tirthlodaya/Pen-Plotter/CAD file Pen plotter/GENERAL_PARTS/20mm-microswitch-1.snapshot.2/Microswitch20.jpg

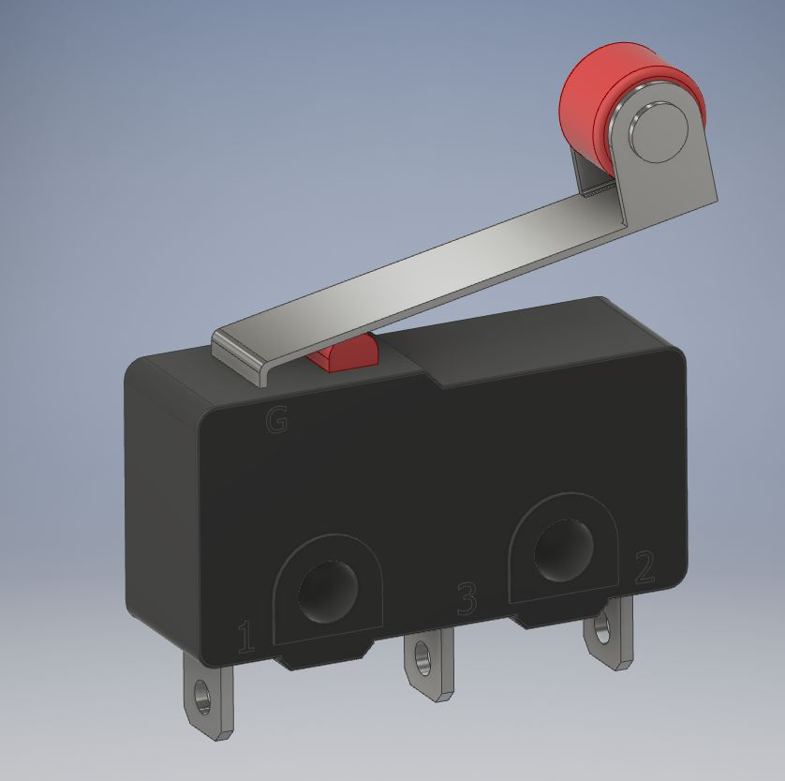
CAD file Pen plotter/GENERAL_PARTS/20mm-microswitch-1.snapshot.2/Microswitch20.jpg
