tirthlodaya/Pen-Plotter/Images_&_Videos_penplotter/full_assembly.jpg

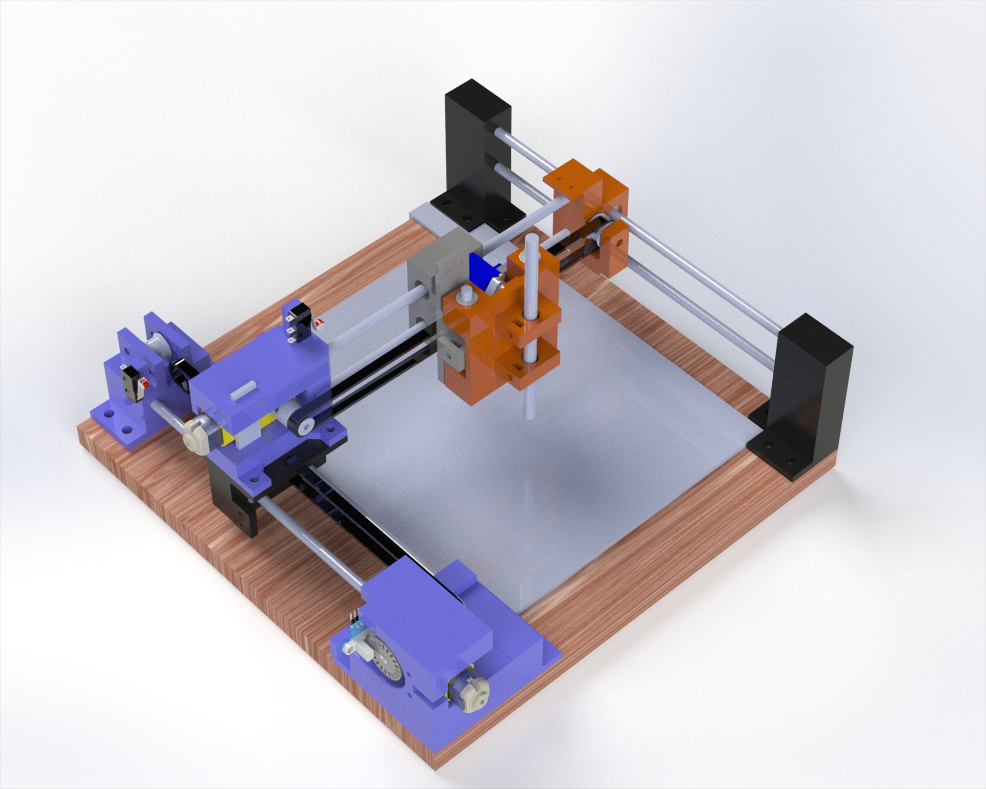
Images_&_Videos_penplotter/full_assembly.jpg
