tirthlodaya/Pen-Plotter/CAD file Pen plotter/dc-motor-gearbox-tt-motor-1.snap 2/DC Motor Gearbox.JPG

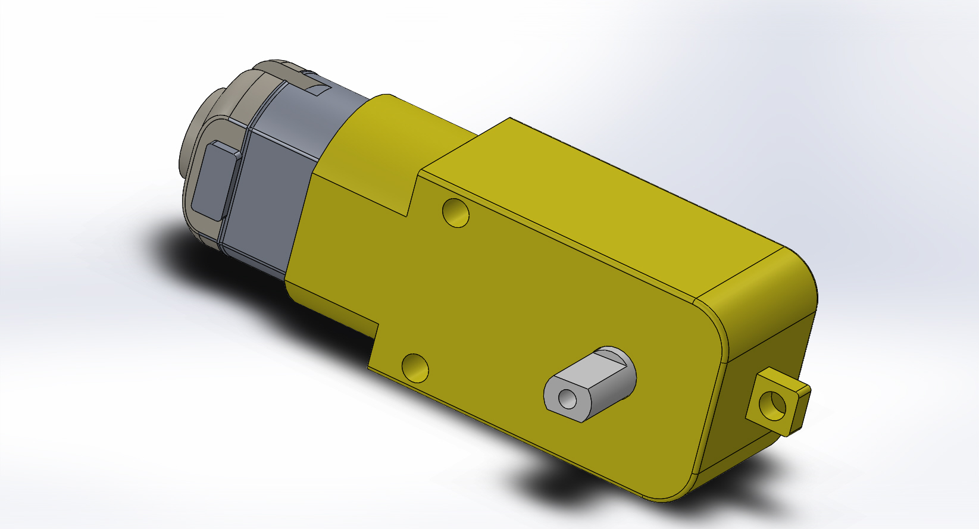
CAD file Pen plotter/dc-motor-gearbox-tt-motor-1.snap 2/DC Motor Gearbox.JPG
