tirthlodaya/Pen-Plotter/electronics_penplotter/circuit diagram.jpg

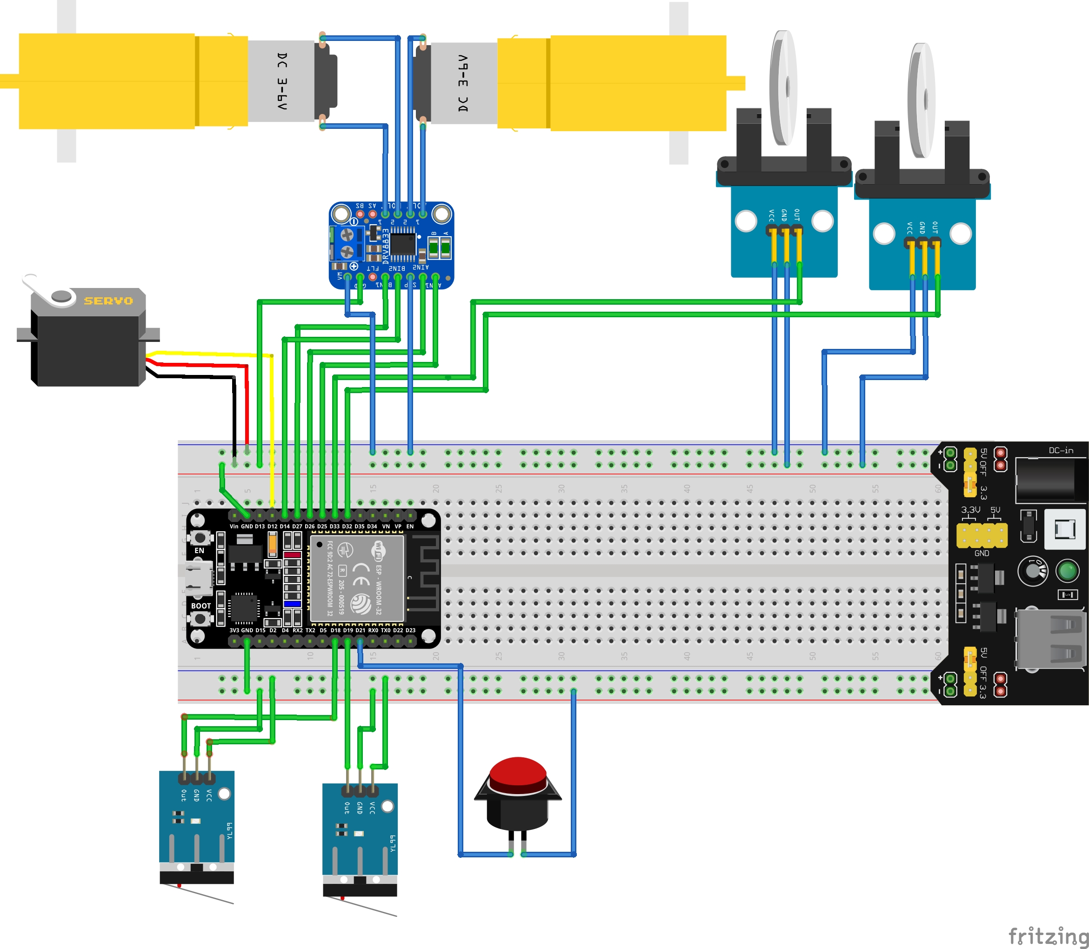
electronics_penplotter/circuit diagram.jpg
