tirthlodaya/Pen-Plotter/electronics_penplotter/Schematic_diagram.jpg

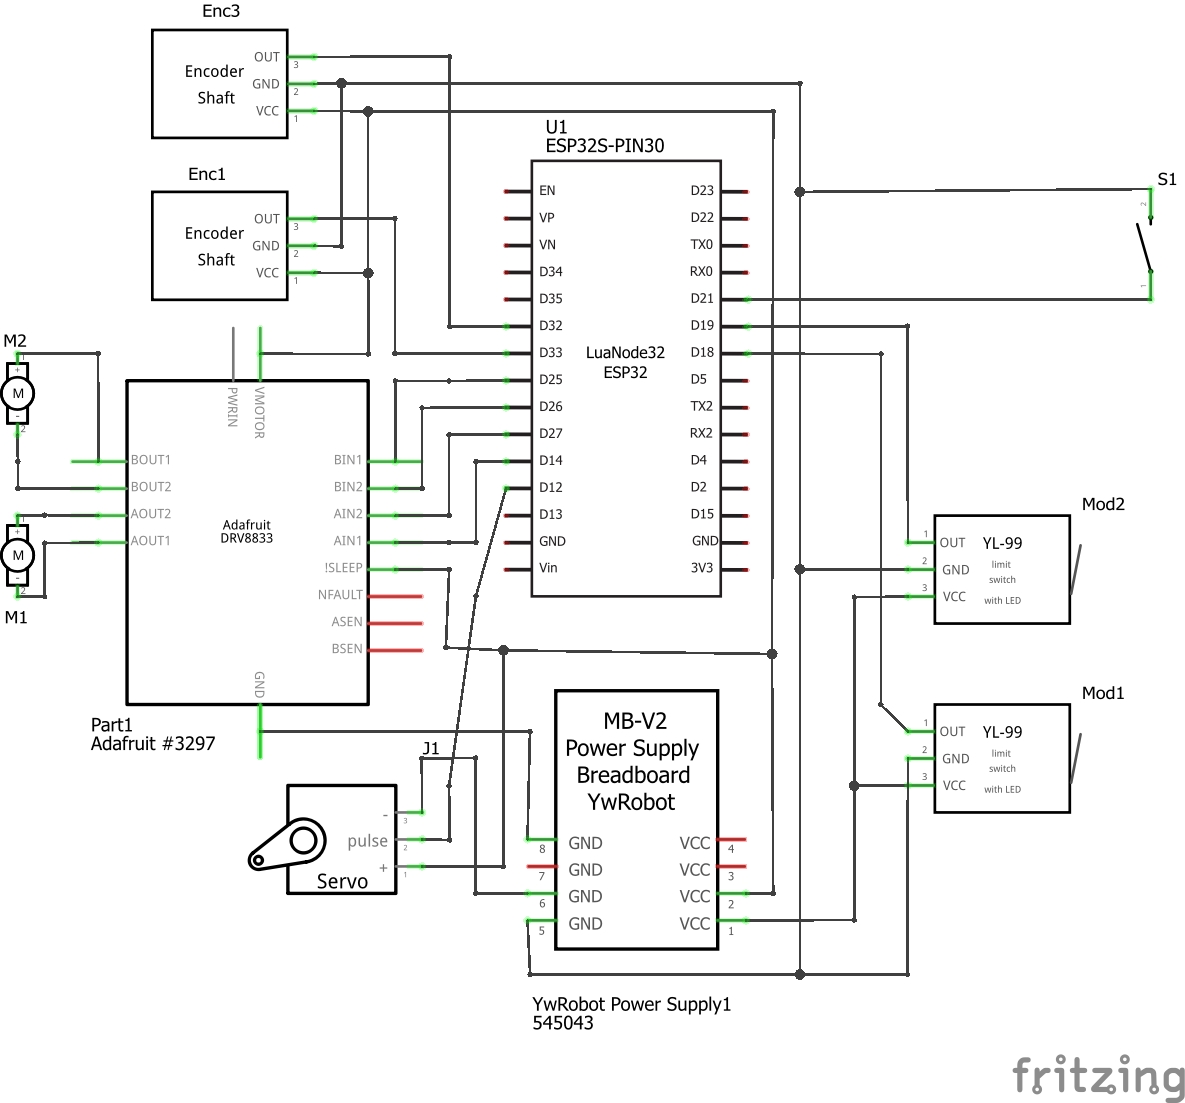
electronics_penplotter/Schematic_diagram.jpg
