tirthlodaya/Pen-Plotter/Images_&_Videos_penplotter/Repeatability_image.jpg

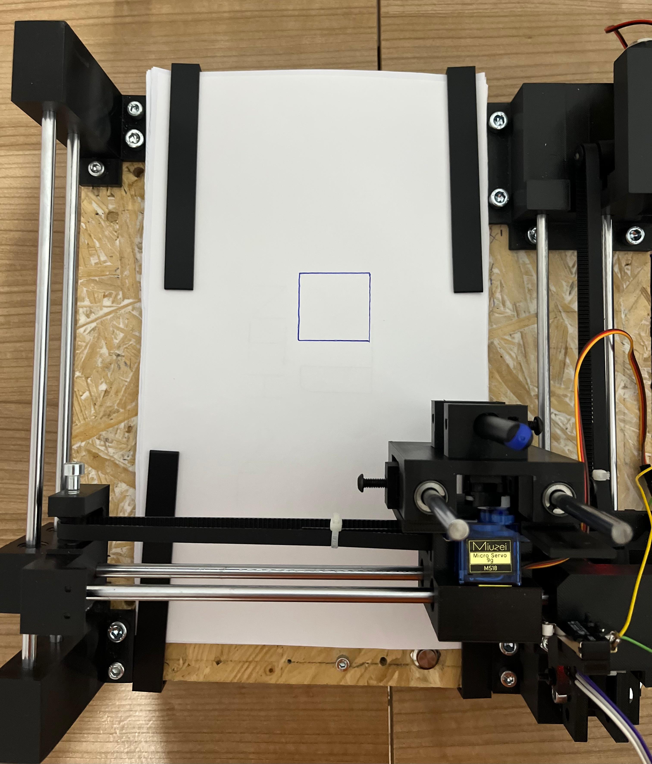
Images_&_Videos_penplotter/Repeatability_image.jpg
