tirthlodaya/Pen-Plotter/documents_penplotter/Requirements_Engineering_XY_PenPlotter.xlsx

User Requirement |  |  |  |  |  |  | Technical Specification |  |  |  |  |  |  |  | Design Specification |  |  |  |  |  |  | Verification Protocol |  |  |  |  |  |  | Verification Report |  |  |  |  |  |  |  |  | Validation Protocol |  |  |  |  | Validation Report
UR # | module | Title | User Requirement | Remark | Domain (HW/SW/ME/all) | Must / Wish | TS # | ref. to UR # | module | Title | Technical Requirement | Remark | Domain (HW/SW/ME/all) | Must / Wish | DS # | ref. to TS # | module | Reference (# bill of materials, article # supplier part, ref. doc # etc..) to implementation | Description | Remark | Domain (HW, SW, ME, all) | VerP # | ref to TS # | module | test procedure (description of routine) | verification criterion | ref. # (i.e. test protocol,etc.) | Domain (HW/SW/ME/all) | VerR # | VerP # | module | Test function | nominal criterion, target value | actual value | criterion passed / failed | remark | Domain (HW/SW/ME/all) | ValP # | ref. to UR # | module | validation procedure (description of routine) | vaidation criteria | ValR # | ref. to ValP # | module | criteria passed / failed
Application |  |  |  |  |  |  | Application |  |  |  |  |  |  |  | Application |  |  |  |  |  |  | Application |  |  |  |  |  |  | Application |  |  |  |  |  |  |  |  | Application
UR1 | application | intended use | The XY-pen plotter is designed to draw a Nikolaus house after programming and can be used within the laboratory of University by students taking part in Master course MERO for educational reasons. |  | all | M | TS1 | UR1 | application | intended use | The plotter is designed and programed to carry out certain tasks and objectives like drawing the Nikolaus hause. |  | all | M | DS1 | TS1 | application | bill of materials | Embedded drawing logic (on the ESP32) that interprets those vectors into coordinated X–Y motion and pen-lift commands. |  | all | VerP1 | TS1 | Application | Upload Nikolaus house drawing to plotter; observe execution. | Plot matches shape/scale of reference drawing. |  | All | VerR1 | VerP1 | Application | Upload Nikolaus house drawing to plotter; observe execution. | Plotter completes full Nikolaus house drawing and in correct sequence | Plot completed successfully | passed |  | All | ValP1 | UR1, UR2,UR9 | application | Run the XY-pen plotter to draw the Nikolaus house for 50 cycles, ensuring correct performance in speed, precision, and accuracy. | The plotter must draw the Nikolaus house correctly in all 50 cycles without errors, maintaining accuracy within defined tolerance limits and operating without failure. | ValR1 | ValP1 | application | passed
UR2 | application | use case | The plotter has to draw a Nikolaus' house |  | all | M | TS2 | UR2 | application | use case | The Nikolaus house has a plotting area of 100 x 100 mm² maximum. |  | all | M | DS2 | TS2 | application | Workshop_II_-_MERO_S25_V2.pdf | Plotting area limited to 100 x 100 mm². |  | all | VerP2 | TS2 | Application | Measure drawing area with ruler. | Plotting area =100×100 mm². |  | All | VerR2 | VerP2 | Application | Measure drawing area with ruler. | Drawing dimensions match design within ±2 mm tolerance | Measured area: 100 mm × 100 mm | passed |  | All | ValP2 | UR3 | application | Test the XY-pen plotter by connecting it to a standard household power supply and running the drawing task for at least 50 cycles. | The plotter must operate reliably and consistently when powered by a household power supply, without power-related issues or interruptions during the 50 cycles. | ValR2 | ValP2 | application | passed
UR3 | application | user environment | The plotter should operate on household power supply |  | all | M | TS3 | UR3 | application | user environment | The plotter should operate on 5V DC . |  | all | M | DS3 | TS3 | application | bill of materials | The plotter should operate on 5V DC . |  | all | VerP3 | TS3 | Application | Supply 5V DC power and test full functionality of the plotter during a complete drawing cycle. | Plotter powers on and operates reliably and safely on 5V DC without performance issues. |  | All | VerR3 | VerP3 | Application | Supply 5V DC power and test full functionality of the plotter during a complete drawing cycle. | Plotter completes full drawing cycle without malfunction | Plot completed successfully | passed |  | All | ValP3 | UR4, UR5 | general | Ensure that the XY-pen plotter can be easily carried by the user and operated by students by testing its portability and user interface, with students successfully completing the drawing task without difficulty. | The plotter should be lightweight and portable for easy handling by the user. The interface must be intuitive, allowing students to operate the plotter with minimal training or assistance. | ValR3 | ValP3 | general | passed
General Functions |  |  |  |  |  |  | General Functions |  |  |  |  |  |  |  | General Functions |  |  |  |  |  |  | General Functions |  |  |  |  |  |  | General Functions |  |  |  |  |  |  |  |  | ValP4 | UR6 | general | Measure the plotter's dimensions and ensure it fits into a designated box for storage. | The plotter must fit comfortably in the box without any parts sticking out or being compressed. | ValR4 | ValP4 | general | passed
UR4 | general | portability | XY pen plotter shall be carried by user. | weight up to 3.5kg. | all | M | TS4 | UR4 | general | portability | The pen plotter should not exceed 3.5 kg |  | all | M | DS4 | TS4 | general |  | Total weight must be under 3.5 kg for portability by a single user. |  | all | VerP4 | TS4 | General | Weigh complete plotter with digital scale. | Total weight ≤3.5 kg. |  | All | VerR4 | VerP4 | General | Weigh complete plotter with digital scale. | Total weight within design limit | less than 3.5kg | passed |  | All | ValP5 | UR10, UR11 | general | Ensure that all components are easy to assemble and the plotter is designed for easy access to replaceable parts. | Components should fit together easily, and parts like the pen, motors, and belts should be accessible for replacement without requiring disassembly. | ValR5 | ValP5 | general | passed
UR5 | general | User Interface | XY Pen Plotter shall be easily operated by the students |  | SW | M | TS5 | UR4 | general | portability | The pen plotter has to be carried by a single user without difficulty |  | SW | M | DS5 | TS5 | general |  | Design the plotter to be lightweight, compact, and ergonomically shaped for easy transport by a single user. |  | SW | VerP5 | TS5 | General | Carry plotter by hand over 200 m distance. | One person carries comfortably without strain. |  | SW | VerR5 | VerP5 | General | Carry plotter by hand over 200 m distance. | No mechanical or electrical damage during/after transport | No damage, powered on and functioned well | passed |  | SW | ValP6 | UR12,UR14 | base plate | Ensure the paper stays in place on the base plate during operation and test the plotter with different paper sizes. | The paper must remain securely in place throughout operation, and the plotter must support multiple paper sizes with easy adjustments. | ValR6 | ValP6 | base plate | passed
UR6 | general | dimensions | XY pen plotter has to fit in a box |  | all | M | TS6 | UR5 | general | User Interface | The plotter should be designed for user friendly operation |  | SW | W | DS6 | TS6 | general |  | Design the plotter with an intuitive interface, clear status indicators, easy pen and paper handling, and automated calibration to ensure user-friendly operation. |  | all | VerP6 | TS6 | General | User operates plotter using interface; record feedback. | User completes basic task without guidance. |  | SW | VerR6 | VerP6 | General | User operates plotter using interface; record feedback. | User able to operate easily; feedback indicates intuitive interface | Interface easy to use; positive feedback | passed |  | SW | ValP7 | UR15 | Frame | Ensure the frame is tested for stability and rigidity during operation. | The frame must remain stable and rigid without any wobbling or flexing during the plotter's operation. | ValR7 | ValP7 | Frame | passed
UR7 | general | Indicator | XY Pen Plotter shall give a signal when it is turned On and shall give a different signal when emergency is pressed |  | SW | W | TS7 | UR6 | general | dimensions | Dimensions less than 56x39x27 cm2 |  | all | M | DS7 | TS7 | general |  | Plotter dimensions must not exceed 56 x 39 x 27 cm³. |  | SW | VerP7 | TS7 | General | Measure dimensions with tape scale of plotter | All dimensions ≤56×39×27 cm³ |  | All | VerR7 | VerP7 | General | Measure dimensions with tape scale of plotter | Dimensions match design within ±2 mm tolerance | 305 x 305 x 15 mm | passed |  | All | ValP8 | UR17,UR18 | Pen-Holder | Ensure the pen-holder is tested to hold pens of various diameters and allow vertical movement. | The pen-holder must securely hold pens of different diameters and enable stable vertical movement during operation. | ValR8 | ValP8 | Pen-Holder | passed
UR8 | general | Dustgaurd | IC-Layout XY Pen Plotter shall be designed such that it should avoid collection of dirt and dust from the environment |  | HW | W | TS8 | UR7 | general | Indicator | An LED light to signal machine operation. |  | SW | W | DS8 | TS8 | general |  | LED light must indicate machine operation clearly. |  | HW | VerP8 | TS8 | General | Power on machine and observe LED status. | LED lights up during operation. |  | SW | VerR8 | VerP8 | General | Power on machine and observe LED status. | Status LEDs turn ON as per expected startup pattern | GREEN LED for Start and RED LED for Emergency | failed |  | SW | ValP9 | UR19,UR20,UR31 | Slider and Acutation | Ensure the plotter uses actuators for customized positioning, maintains high precision and accuracy in slider movement, and effectively translates rotary motor motion into smooth linear movement. | The plotter must use actuators that allow customized positioning, with the slider maintaining high precision and accuracy for detailed plots, and the rotary motion of the motor must be seamlessly converted into smooth, accurate linear movement. | ValR9 | ValP9 | Slider and Acutation
UR9 | general | Lifecycle | Pen-Plotter should operate atleast 50 cycle |  | all | W | TS9 | UR8 | general | Circuit Protection | 3D printed box to prevent dust and dirt. |  | HW | W | DS9 | TS9 | general | bill of materials | Enclosure must be 3D printed to shield against dust and dirt. |  | all | VerP9 | TS9 | General | Inspect enclosure material and fitment. | 3D-printed box fully covers and seals system. |  | HW | VerR9 | VerP9 | General | Inspect enclosure material and fitment. | Enclosure securely fitted, no loose parts, durable material | Stable 3D printed material for casing | passed |  | HW | ValP10 | UR22,UR23 | Motor Controller | Ensure the voltage and current are regulated to the motors during operation. | The motors should receive stable, regulated voltage and current to prevent performance issues or damage. | ValR10 | ValP10 | Motor Controller | passed
UR10 | general | Assembly | All component are easy to assemble. |  | all | M | TS10 | UR9 | general | Lifecycle | Closed loop control for higher lifecycle |  | all | W | DS10 | TS10 | general |  | Implement closed-loop motor control using feedback sensors to monitor and adjust motion in real time, ensuring precise operation, reduced wear, and extended component lifespan |  | all | VerP10 | TS10 | General | Check sensor feedback and correction loop. | System adjusts based on sensor feedback. |  | All | VerR10 | VerP10 | General | Check sensor feedback and correction loop. | Sensors provide accurate data; system corrects position as expected | Encoder feedback working, path corrected | passed |  | All | ValP11 | UR24,UR25,UR26,UR29 | Control and Coding | Ensure the drive system has selectable preset speeds, regulated voltage and current to motors, seamless integration with a microcontroller, limit switches for origin detection, an emergency stop provision, and automatic home position calibration. | The system must provide selectable preset speeds, stable motor regulation, integrate seamlessly with the microcontroller, accurately detect the origin via limit switches, include an operational emergency stop, and automatically calibrate to the home position before each operation. | ValR11 | ValP11 | Control and Coding | passed
UR11 | general | Ease of Maintenance | Ensure the plotter is designed for easy access to replaceable parts. |  | all | M | TS11 | UR10, UR11 | general | Assembly | All components of the pen plotter are modularily designed |  | all | M | DS11 | TS11 | general | Assembly_group16 | All components must be modular for easy maintenance and upgrade. |  | all | VerP11 | TS11 | General | Try removing modules | Modules can be separated easily |  | All | VerR11 | VerP11 | General | Try removing modules | Modules can be safely disconnected without damaging system or other components | Modules removable, no damage observed | passed |  | All | ValP12 | UR30, UR31 | Wiring and Power supply | Ensure standardized wires are used, all wires are inside a cable protector, and the plotter operates reliably on direct electrical power without batteries. | The plotter must have standardized wiring with all wires protected inside a cable protector and must operate reliably on direct electrical power without the use of batteries. | ValR12 | ValP12 | Wiring and Power supply | passed
Module Function base plate |  |  |  |  |  |  | Module Function base plate |  |  |  |  |  |  |  | Module Function base plate |  |  |  |  |  |  | Module Function base plate |  |  |  |  |  |  | Module Function - base plate |  |  |  |  |  |  |  |  | ValP13 | UR33,UR35 | Regulatory & standards | Ensure the device is designed according to relevant safety standards, and verify that the firmware follows established coding standards for reliability and maintainability. | The device must comply with applicable safety standards, and the firmware must adhere to coding standards to ensure long-term reliability and ease of maintenance. | ValR13 | ValP13 | Regulatory & standards | passed
UR12 | base plate | paper fixation | The paper should stay in place on the base plate during operation. | Implement grips | HW | M | TS12 | UR12 | base plate | Paper fixation | The base plate have to be encapsulated with grippers to hold the paper in proper position w/o movement during drawing cylce |  | HW | M | DS12 | TS12 | base plate | Assembly_group16 | Paper holding system (grippers) to prevent movement during plotting. |  | HW | VerP12 | TS12 | base plate | Plot and check paper movement | Paper stays fixed throughout cycle |  | HW | VerR12 | VerP12 | base plate | Plot and check paper movement | Paper does not move during operation | Smooth paper feed,stable and aligned | passed |  | HW
UR13 | Base Plate | Quality | The base plate shall be made of good quality material | - | HW | M | TS13 | UR13 | base plate | Quality | the base surface should be smooth, low-maintenance, durable. |  | HW | M | DS13 | TS13 | base plate |  | Base surface must be smooth, durable, and low-maintenance. |  | HW | VerP13 | TS13 | base plate | Inspect and touch base surface | Base is smooth, easy to clean |  | HW | VerR13 | VerP13 | base plate | Inspect and touch base surface | Base surface is flat, stable, and vibration-free | Not Smooth, no vibration | failed |  | HW
UR14 | Base Plate | Dimension | Supports multiple different paper sizes | - | HW | M | TS14 | UR14 | base plate | Dimensions | The dimension of base plate should be such that it can hold paper from 10x10 cm upto A4 Size |  | HW | W | DS14 | TS14 | base plate | Workshop_II_-_MERO_S25_V2.pdf | Base plate must support paper from 10x10 cm to A4 size. |  | HW | VerP14 | TS14 | base plate | Try fitting both sizes | Both sizes fit securely on base |  | HW | VerR14 | VerP14 | base plate | Try fitting both sizes | Plotter accommodates both intended paper sizes securely | A4 and A5 fit securely | passed |  | HW
Module Function - Frame |  |  |  |  |  |  | Module Function frame |  |  |  |  |  |  |  | Module Function frame |  |  |  |  |  |  | Module Function frame |  |  |  |  |  |  | Module Function frame
UR15 | Frame | Structure Layout | The frame must be stable and rigid. |  | all | M | TS15 | UR15 | Frame | Structure Layout | The frame shall maintain structural stability and rigidity to minimize vibrations during operation, ensuring plotting accuracy with a maximum positional deviation of less than 0.5 mm. |  | all | M | DS15 | TS15 | Frame | Assembly_group16 | Structure must be rigid and stable to avoid vibration. |  | all | VerP15 | TS15 | Frame | Observe motion during plotting | No visible vibrations; smooth plotting |  | All | VerR15 | VerP15 | Frame | Observe motion during plotting | Motion is smooth, with no jitter, backlash, or sudden stops | Motion smooth and consistent | passed |  | All
UR16 | Frame | Structure Layout | Maintain Alignment and Perpendicularity of Motion Axes |  | all | M | TS16 | UR16 | Frame | Structure Layout | The X and Y motion axes shall maintain perpendicularity within ±1° angular deviation and linear alignment within 0.5 mm to ensure precise, smooth, and accurate pen movement. |  | all | M | DS16 | TS16 | Frame | Assembly_group16 | X and Y motion axes must have ±1° perpendicularity and 0.5 mm linear alignment. |  | all | VerP16 | TS16 | Frame | Check angle and linear deviation | Deviation ≤ ±1° and ≤0.5 mm |  | All | VerR16 | VerP16 | Frame | Check angle and linear deviation | Positional deviation ≤ 0.5 cm; angular deviation ≤ ±5° | deviation greater than 0.5cm | failed |  | All
Module Function - pen holder |  |  |  |  |  |  | Module Function Pen Holder |  |  |  |  |  |  |  | Module Function Pen Holder |  |  |  |  |  |  | Module Function Pen Holder |  |  |  |  |  |  | Module Function - Pen Holder
UR17 | Pen-Holder | Pen Grip | Pen-Holder shall be designed to hold pen of various diameter and it should be stable. |  | HW | W | TS17 | UR17 | Pen-Holder | Pen Grip | The pen-holder shall be adjustable to securely hold pens with diameters ranging from7 mm to 10 mm, ensuring stable positioning during plotting. |  | HW | W | DS17 | TS17 | Pen-Holder | Assembly_group16 | Pen-holder must support pen diameters 7–10 mm, securely. |  | HW | VerP17 | TS17 | Pen Plotter | Insert pens of 7 mm, 8.5 mm, and 10 mm diameter and run a test plot. Observe for slippage or instability. | Pens fit securely without wobbling and remain stable during plotting. |  | HW | VerR17 | VerP17 | Pen Plotter | Insert pens of 7 mm, 8.5 mm, and 10 mm diameter and run a test plot. Observe for slippage or instability. | All pens fit securely and plot without slippage | All pens tested; no slippage observed | passed |  | HW
UR18 | Pen-Holder | movement | Allow vertical movement |  | ME | M | TS18 | UR18 | Pen-Holder | Movement | The pen-holder shall allow smooth vertical movement facilitated by a servo-driven bearing mechanism, ensuring precise and repeatable pen lift and placement during operation. |  | ME | M | DS18 | TS18 | Pen-Holder | Assembly_group16 | Pen lift must use servo-driven vertical movement with bearing support. |  | ME | VerP18 | TS18 | Pen Plotter | Observe servo-driven pen movement during repeated lift/drop cycles and assess consistency. | Pen lifts and lowers smoothly and returns to the same position with precision across multiple cycles. |  | ME | VerR18 | VerP18 | Pen Plotter | Observe servo-driven pen movement during repeated lift/drop cycles and assess consistency. | Pen lifts and drops consistently across multiple cycles | 20 cycles successful with no variance | passed |  | ME
Module Function - Slider |  |  |  |  |  |  | Module Function Slider |  |  |  |  |  |  |  | Module Function Slider |  |  |  |  |  |  | Module Function Slider |  |  |  |  |  |  | Module Function - Function Slider
UR19 | Slider | Movement | The slider must maintain high precision and accuracy in movement to produce detailed and consistent plots. |  | all | W | TS19 | UR19 | Slider | Movement | Top quality linear and normal bearings having high number of revolutions are used for accurate movements. |  | all | W | DS19 | TS19 | Slider | bill of materials | Motion system must use high-revolution linear and rotary bearings. |  | all | VerP19 | TS19 | Slider | Inspect bearing specs | Bearings rotate smoothly and durably |  | All | VerR19 | VerP19 | Slider | Inspect bearing specs | Bearings meet design spec | 6 mm ID bearings rotate smoothly | passed |  | All
UR20 | Slider | Motion | Translate Rotary Motion of Motor into Linear Movement |  | all | M | TS20 | UR20 | Slider | Motion | The rotary motion of the motor shall be accurately converted into linear movement using belt-drive mechanism, ensuring precise positioning of the pen carriage along the motion axes. |  | all | M | DS20 | TS20 | Slider | bill of materials | A GT2 timing belt and pulley system is used to convert the rotary motion of the DC motor into linear movement of the pen carriage, achieving a positioning accuracy of ±5 mm |  | all | VerP20 | TS20 | Slider | Observe belt drive converting rotation to linear motion and measure the line distance | Precise pen positioning without backlash, distance measured is same. |  | All | VerR20 | VerP20 | Slider | Observe belt drive converting rotation to linear motion and measure the line distance | Belt drive converts motion without skipping or backlash with accuracy of ±5 mm | No belt slip, linear motion accurate and distance measure withing error range | passed |  | All
Module Function - Motor Controller |  |  |  |  |  |  | Module Function Motor Controller |  |  |  |  |  |  |  | Module Function Motor Controller |  |  |  |  |  |  | Module Function Motor Controller |  |  |  |  |  |  | Module Function - Motor Controller
UR21 | Motor Controller | Specifications | Motor controller must provide precise control for accurate pen plotting. |  | ME | M | TS21 | UR21, UR23 | Motor Controller | Specification | DRV8833 motor driver - Control motor speed, torque, self-tune to motor parameters. |  | ME | M | DS21 | TS21 | Motor Controller | bill of materials | Use DRV8833 motor driver for speed, torque control, and tuning. |  | ME | VerP21 | TS21 | Controller | Control motor speed/torque via DRV8833 and monitor behavior | Motor responds smoothly to command changes and operates reliably |  | ME | VerR21 | VerP21 | Controller | Control motor speed/torque via DRV8833 and monitor behavior | Motor responds proportionally to PWM input; torque control is effective | PWM range working; torque changes smooth | passed but not Implemented |  | ME
UR22 | Motor Controller | Motor | A drive system with selectable preset speeds is required. |  | ME | W | TS22 | UR22 | Motor Controller | Motor | Use of DC motor(DC-130) and servo motor(9G micro). |  | ME | M | DS22 | TS22 | Motor Controller | bill of materials | Use Feetech DC-130 motors for movement, and 9G servo motor for pen actuation. |  | ME | VerP22 | TS22 | Controller | Power and test DC and servo motors individually | Motors perform as intended under load and command |  | ME | VerR22 | VerP22 | Controller | Power and test DC and servo motors individually | Both motors operate smoothly and respond to commands without delay | All motors tested; no delay in response | passed |  | ME
UR23 | Motor Controller | Regulator | Regulate Voltage and Current to Motors |  | all | M
Module Function - Control and Coding |  |  |  |  |  |  | Module Function Control and coding |  |  |  |  |  |  |  | Module Function Control and coding |  |  |  |  |  |  | Module Function Control and Coding |  |  |  |  |  |  | Module Function Control and Coding
UR24 | Control and Coding | Integration | The plotter should seamlessly integrate with Microcontroller |  | all | M | TS23 | UR24 | Control and Coding | Integration | integration with Microcontroller ESP32 and compatability with Arduino IDE |  | all | M | DS23 | TS23 | Control and Coding | bill of materials | Microcontroller: ESP32, compatible with Arduino IDE. | We are planning to design an API communicate between the DWG file and G-Code. | all | VerP23 | TS23 | Control and Coding | Connect ESP32 to PC and upload code via Arduino IDE | Successful code upload and program execution verified |  | All | VerR23 | VerP23 | Control and Coding | Connect ESP32 to PC and upload code via Arduino IDE | Code uploads successfully without errors | Code uploaded successfully | passed |  | All
UR25 | Control and Coding | Limit Switch | Limit switches shall be used to detect origin. |  | SW | M | TS24 | UR25,UR29 | Control and Coding | Limit Switch | XSS-5GL13 limit switch shall be installed to accurately detect the origin (home) position of the pen carriage, providing reliable and repeatable zero-point reference for motion control and preventing overtravel. |  | SW | W | DS24 | TS24 | Control and Coding | bill of materials | Install XSS-5GL13 limit switches for homing and overtravel protection. |  | SW | VerP24 | TS24 | Control and Coding | Run homing routine and observe carriage stopping at switch | Switch consistently defines home position with no overshoot |  | All | VerR24 | VerP24 | Control and Coding | Run homing routine and observe carriage stopping at switch | Carriage stops precisely at limit switch during homing | 10/10 tests passed | passed |  | All
UR26 | Control and Coding | Emergency Switch | Provision for emergency stop should be available. |  | SW | M | TS25 | UR26 | Control and Coding | Emergency Switch | An emergency stop push button is provided to immediately halt all operations of the pen plotter, ensuring user safety and preventing equipment damage. |  | SW | M | DS25 | TS25 | Control and Coding | bill of materials | It features a flat-head emergency stop button with a 12 mm diameter press stud |  | SW | VerP25 | TS25 | Control and Coding | Press emergency stop during operation and observe behavior | Plotter immediately halts all activity when button is pressed |  | SW | VerR25 | VerP25 | Control and Coding | Press emergency stop during operation and observe behavior | All motors stop immediately and system disables further motion until reset | Motors stopped instantly; system halted for 2s goes to home position | passed |  | SW
UR27 | Control and Coding | Speed Control | The system must be able to accurately monitor and display the motor's speed in real-time. |  | SW | W | TS26 | UR27 | Control and Coding | Motor speed control | Speed measurement sensor IR infrared slot optocoupler module Light-nodemcu-development-board barrier sensor for motor speed detection |  | SW | W | DS26 | TS26 | Control and Coding | code_file_group16 | Install IR optocoupler module for motor speed feedback. |  | SW | VerP26 | TS26 | Control and Coding | Rotate motor and observe IR sensor signal output via serial monitor | Sensor produces consistent pulses corresponding to motor speed |  | SW | VerR26 | VerP26 | Control and Coding | Rotate motor and observe IR sensor signal output via serial monitor | Sensor outputs consistent pulse signals corresponding to motor rotation | Signal pulses almost matched expected RPM pattern | failed |  | SW
UR28 | Control and Coding | Speed Control | Generate Signals for Motor Controller |  | SW | W | TS27 | UR28 | Control and Coding | Motor speed control | The system shall generate PWM (Pulse Width Modulation) signals with adjustable duty cycles (0–100%) to control the motor speed through the motor driver. |  | SW | W | DS27 | TS27 | Control and Coding |  | The ESP32 shall generate PWM signals at 60% duty cycle resolution for motor speed control. |  | SW | VerP27 | TS27 | Control and Coding | Vary PWM duty cycle and confirm smooth motor speed change. | Motor should run at 60% of its max speed with ±5% tolerance. |  | SW | VerR27 | VerP27 | Control and Coding | Vary PWM duty cycle and confirm smooth motor speed change. | 60% of the motor's maximum speed | Measured RPM is almost equal to expected RPM | failed |  | SW
UR29 | Control and Coding | Automated Calibration | The device should automatically calibrate to home position before operation. |  | all | M
Module Function - Wiring |  |  |  |  |  |  | Module Function Wiring |  |  |  |  |  |  |  | Module Function Wiring |  |  |  |  |  |  | Module Function Motor Controller |  |  |  |  |  |  | Module Function Motor Controller
UR30 | Wiring | safety | Standardized wire used, all wires are inside a cable protector. |  | HW | W | TS28 | UR30 | Wiring | Safety | Prototype wiring uses jumper wires on a breadboard but is neatly routed and secured; final wiring shall comply with VDE insulation and protection standards |  | HW | W | DS28 | TS28 | Wiring | bill of materials | Prototype wiring may use jumper wires neatly; final wiring must follow VDE 0100, VDE 0295 standards. |  | HW | VerP28 | TS28 | Wiring | For prototype wiring, ensure that all connections are secure and functional, test signal integrity and check for proper operation without electrical faults. | For prototype wiring, verify that signal integrity is maintained, electrical continuity exists |  | HW | VerR28 | VerP28 | Wiring | For prototype wiring, ensure that all connections are secure and functional, test signal integrity and check for proper operation without electrical faults. | All connections should be continuous with no open circuits. | all connections are continuous, with no interruptions. | passed |  | HW
Module Function - Power Supply |  |  |  |  |  |  | Module Function power supply |  |  |  |  |  |  |  | Module Function power supply |  |  |  |  |  |  | Module Function Power supply |  |  |  |  |  |  | Module Function Power Supply
UR31 | Power Supply | Requirement | The pen plotter must operate reliably on direct electrical power without the need for batteries. |  | HW | M | TS29 | UR31 | Power Supply | Connection | 2 channel power supply 3.3V 5V MB102 Breadboard Power Supply Module |  | HW | M | DS29 | TS29 | Power Supply | bill of materials | Use MB102 2-channel power supply module (3.3V / 5V). |  | SW | VerP29 | TS29 | Connection | Measure voltage outputs with multimeter at both channels | Output remains steady at 3.3V and 5V under load |  | HW | VerR29 | VerP29 | Connection | Measure voltage outputs with multimeter at both channels | Voltage levels within expected range | Within range 0-5V | passed |  | HW
Module Function - Actuator |  |  |  |  |  |  | Module Function Actuator |  |  |  |  |  |  |  | Module Function Actuator |  |  |  |  |  |  | Module Function actuator |  |  |  |  |  |  | Module Function actuator
UR32 | Actuator | Actuation | Actuators allowing customized positioning or movement. |  | HW | M | TS30 | UR32 | Actuator | Actuation | DC motors provide smooth, controllable linear motion; the servo offers accurate pen lift with adjustable pen pressure |  | HW | M | DS30 | TS30 | Actuator | bill of materials | Use DC motors for precise and stable X-Y axis movement and a servo motor for controlled pen lifting with adjustable pressure to ensure accurate and consistent plotting. |  | SW | VerP30 | TS30 | Actuation | Test motion and pen lift in drawing routine | Motion is smooth; pen lifts and presses with correct pressure |  | HW | VerR30 | VerP30 | Actuation | Test motion and pen lift in drawing routine | Motors move correctly and servo lifts/drops pen at expected positions | Pen lift synced; drawing sequence correct | passed |  | HW
Regulatory and Standards |  |  |  |  |  |  | Regulatory and Standards |  |  |  |  |  |  |  | Regulatory and Standards |  |  |  |  |  |  | Regulatory and Standards |  |  |  |  |  |  | Regulatory and Standards
UR33 | Regulatory & standards | conformity to standards | Device has to be designed according corresponding standards, i.e. for safety, valid for the product |  | all | M | TS31 | UR33 | Regulatory & standards | conformity to standards | Meet the CE conformity and EN 60335 should be satisfied. |  | all | W | DS31 | TS31 | Regulatory & standards |  | Must comply with CE conformity and EN 60335 standards. |  | all | VerP31 | TS31 | conformity to standards | Review product documentation and CE/EN markings | CE marking is present and EN 60335 compliance documented |  | All | VerR31 | VerP31 | conformity to standards | Review product documentation and CE/EN markings | Documentation is complete and device bears appropriate CE/EN compliance markings | Documentation reviewed | passed |  | All
UR34 | Regulatory & standards | Electrical Safety | Compliance with local/international electrical safety standards. Overcurrent protection, insulation, grounding. |  | all | M | TS32 | UR34 | Regulatory & standards | Electrical Safety | All electrical components and wiring shall comply with relevant safety standards (e.g., VDE 0100), include proper insulation, grounding, and use protective devices such as fuses or circuit breakers. |  | all | W | DS32 | TS32 | Regulatory & standards |  | All electrical components must be insulated, grounded, and protected via fuses/breakers. |  | all | VerP32 | TS32 | Electrical Safety | Inspect wiring, insulation, and safety features such as fuse or breaker | Wiring follows safety standards; insulation and protection are confirmed |  | All | VerR32 | VerP32 | Electrical Safety | Inspect wiring, insulation, and safety features such as fuse or breaker | Wiring is secure, insulation intact, and safety components | All wiring almost neat | failed |  | All
UR35 | Regulatory & standards | Software & Firmware Compliance | Ensuring firmware follows coding standards for reliability and maintainability. |  | all | M | TS33 | UR35 | Regulatory & standards | Software & Firmware Compliance | Firmware shall implement secure coding, error handling, and support safe updates, complying with relevant embedded system standards. |  | all | M | DS33 | TS33 | Regulatory & standards |  | Firmware must implement secure coding, proper error handling, and safe updates. |  | all | VerP33 | TS33 | Software & Firmware Compliance | Review firmware logic and update process | Secure coding and safe update procedures are implemented and documented |  | All | VerR33 | VerP33 | Software & Firmware Compliance | Review firmware logic and update process | Firmware operates as intended and can be updated via standard process | Firmware update successful; logic verified | passed |  | All
 |  |  | 0
