tirthlodaya/Pen-Plotter/CAD file Pen plotter/FULL_ASSEMBLY/full assembly.SLDASM

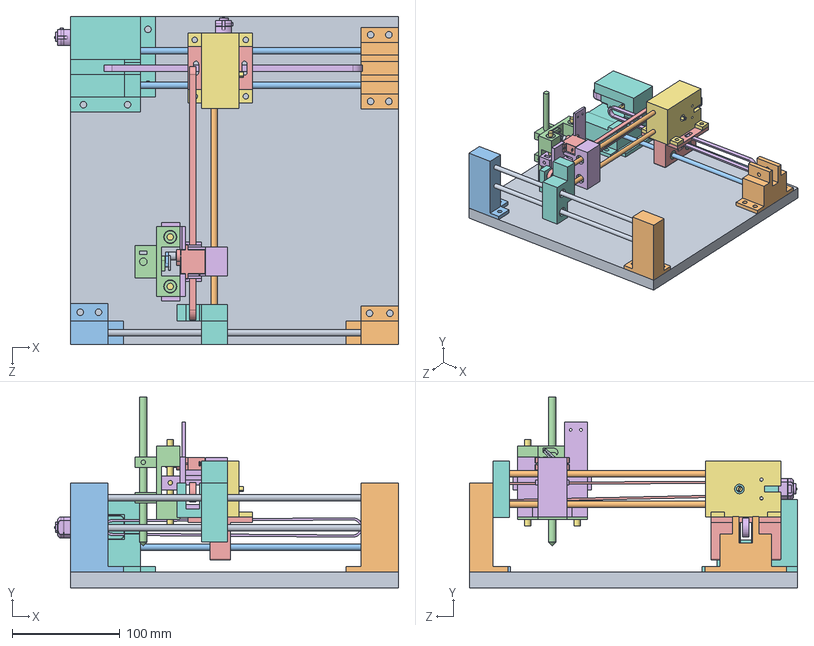
[picture p18: CAD file, 2025-08-06]
CAD file Pen plotter/FULL_ASSEMBLY/full assembly.SLDASM
320.0 x 177.6 x 305.0 mm
Gearbox x 2
output shaft x 2
motor x 2
y_axis_trolley
LMU_N6 x 10
y_axis_shaft x 2
y_axis_right support
base Of Pen Plotter
y axis rod support_w_motor
x axis rod support_w_motor
x axis moving guide
servo sg-90
z_axis movable part
rotating_part on servo
x_axis shaft x 2
SG90_Arm_01_Custom
x_axis_end_support_guide
z_axis shaft x 2
y axis belt
x axis belt
pen
y_axis_parallel_support
y_axis_parallel_support_back
y_axis_parallel_shaft x 2
