tirthlodaya/Pen-Plotter/CAD file Pen plotter/FULL_ASSEMBLY/Full_Assembly_Deliverable_1_Team_16.STEP

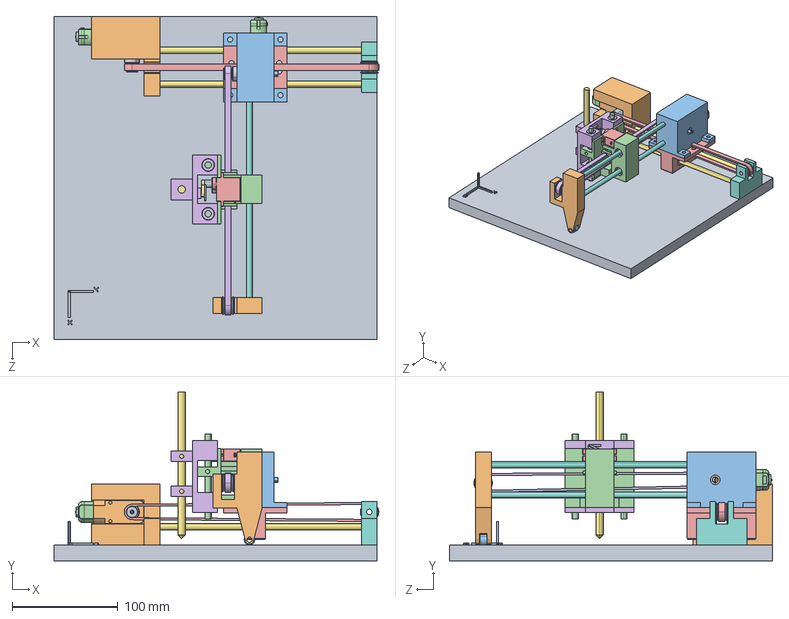
[picture p19: CAD file, 2025-08-06]
CAD file Pen plotter/FULL_ASSEMBLY/Full_Assembly_Deliverable_1_Team_16.STEP
306.5 x 159.5 x 305.0 mm
Gearbox.STEP x 2
output shaft.STEP x 2
motor.STEP x 2
gear_pulley_Motor1.stp.STEP x 2
y_axis_trolley.STEP
LMU_N6_LMU-N6.STEP x 8
shaft.STEP x 2
y_axis_right support.STEP
base Of Pen Plotter.STEP
Move_pulley.stp.STEP x 2
y axis rod support_w_motor.STEP
x axis rod support_w_motor.STEP
x axis moving guide.STEP
servo sg-90.STEP
z_axis movable part.STEP
rotating_part on servo.STEP
x_axis shaft.STEP x 2
SG90_Arm_01_Custom.STEP
x_axis end support with roller.STEP
roller.STEP
z_axis shaft.STEP x 2
y axis belt.STEP
x axis belt.STEP
pen.STEP
