tirthlodaya/Pen-Plotter/CAD file Pen plotter/dc-motor-gearbox-tt-motor-1.snap 2/DC Motor Gearbox.STEP

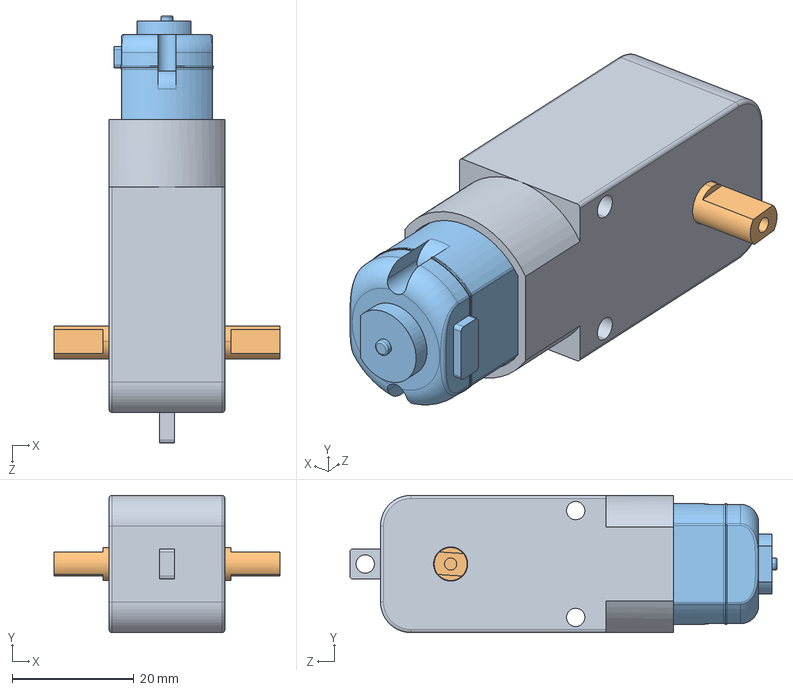
[picture p20: CAD file, 2025-08-06]
CAD file Pen plotter/dc-motor-gearbox-tt-motor-1.snap 2/DC Motor Gearbox.STEP
37.0 x 22.5 x 70.0 mm
Gearbox
output shaft
motor
