tirthlodaya/Pen-Plotter/CAD file Pen plotter/extra/fixed position PART.SLDPRT

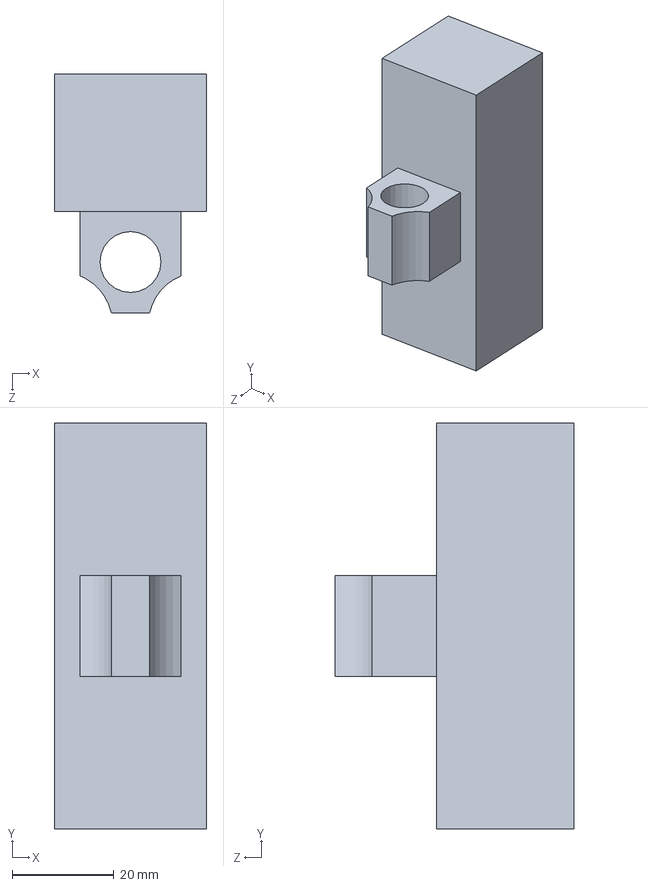
[picture p21: CAD file, 2025-08-06]
CAD file Pen plotter/extra/fixed position PART.SLDPRT
30.0 x 80.0 x 47.0 mm
