tirthlodaya/Pen-Plotter/CAD file Pen plotter/GENERAL_PARTS/20mm-microswitch-1.snapshot.2/Microswitch 20mm.stp

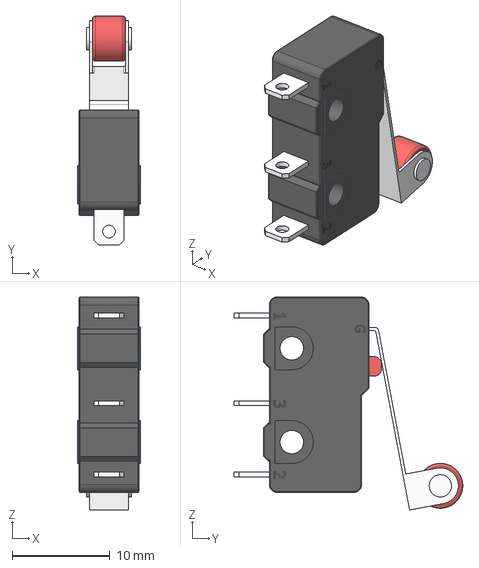
[picture p22: CAD file, 2025-08-06]
CAD file Pen plotter/GENERAL_PARTS/20mm-microswitch-1.snapshot.2/Microswitch 20mm.stp
6.40 x 23.4 x 21.8 mm
