tirthlodaya/Pen-Plotter/CAD file Pen plotter/GENERAL_PARTS/roller.SLDPRT

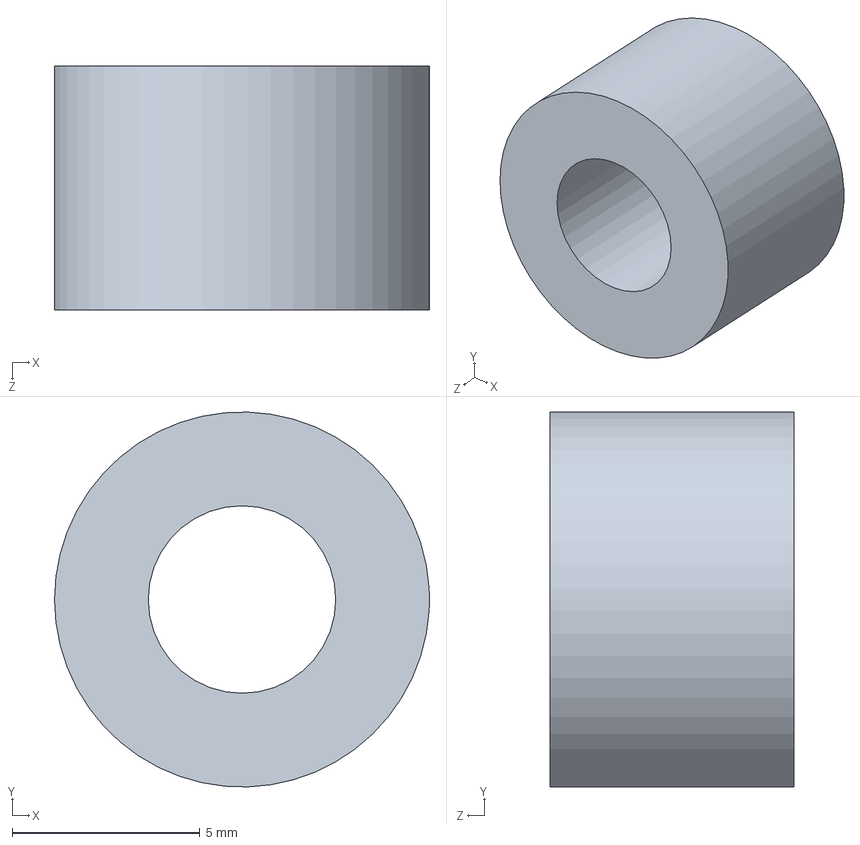
[picture p23: CAD file, 2025-08-06]
CAD file Pen plotter/GENERAL_PARTS/roller.SLDPRT
10.0 x 10.00 x 6.50 mm
