tirthlodaya/Pen-Plotter/CAD file Pen plotter/lmu-n6-1.snapshot.1/LMU_N6.sldprt

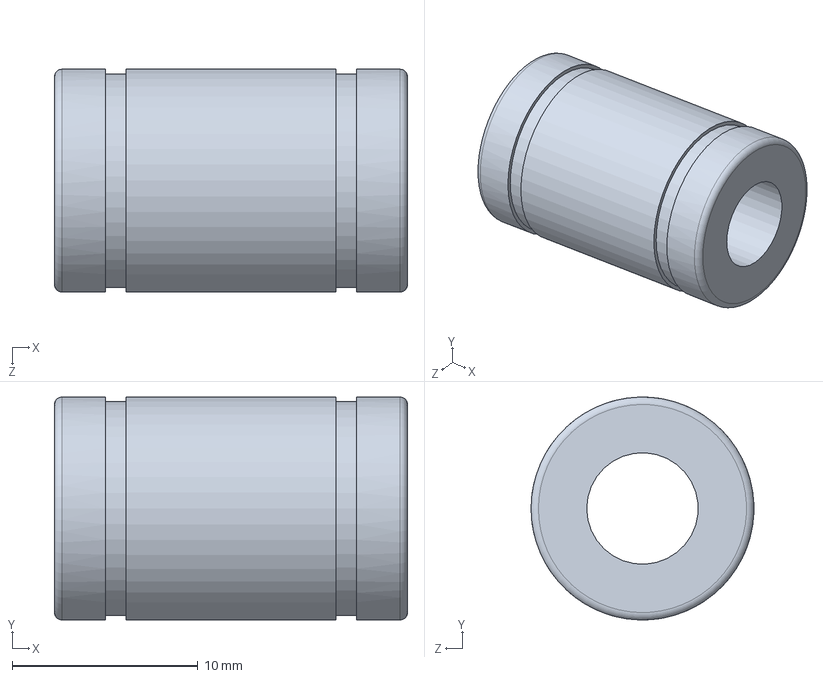
[picture p24: CAD file, 2025-08-06]
CAD file Pen plotter/lmu-n6-1.snapshot.1/LMU_N6.sldprt
19.0 x 12.0 x 12.0 mm
