tirthlodaya/Pen-Plotter/CAD file Pen plotter/SERVO/servo sg-90.SLDPRT

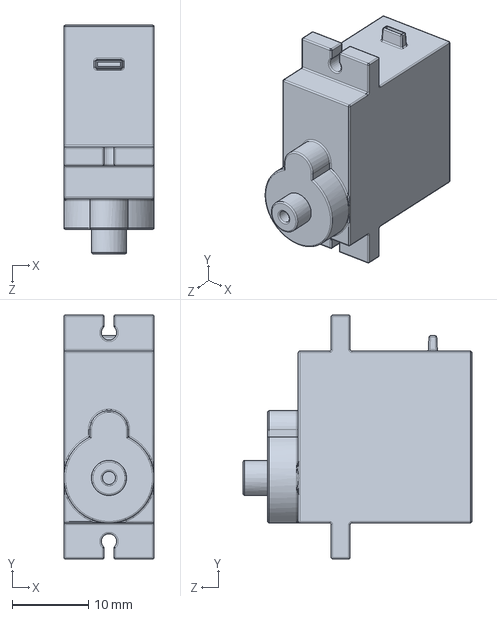
[picture p25: CAD file, 2025-08-06]
CAD file Pen plotter/SERVO/servo sg-90.SLDPRT
11.8 x 31.9 x 29.9 mm
