tirthlodaya/Pen-Plotter/CAD file Pen plotter/X_AXIS_PARTS/x axis moving guide.SLDPRT

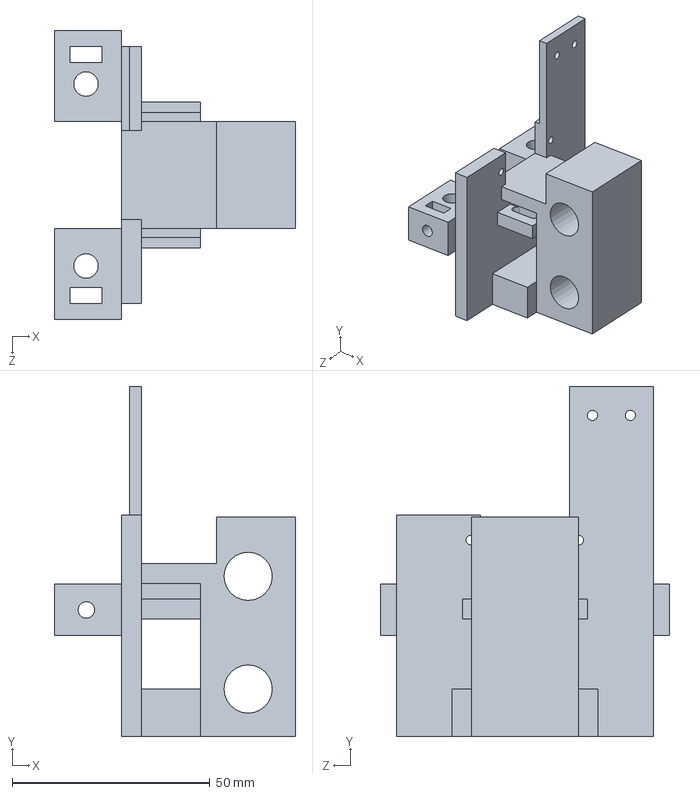
[picture p26: CAD file, 2025-08-06]
CAD file Pen plotter/X_AXIS_PARTS/x axis moving guide.SLDPRT
61.0 x 88.5 x 73.0 mm
