tirthlodaya/Pen-Plotter/CAD file Pen plotter/Y_AXIS_PARTS/y_axis_parallel_shaft.SLDPRT

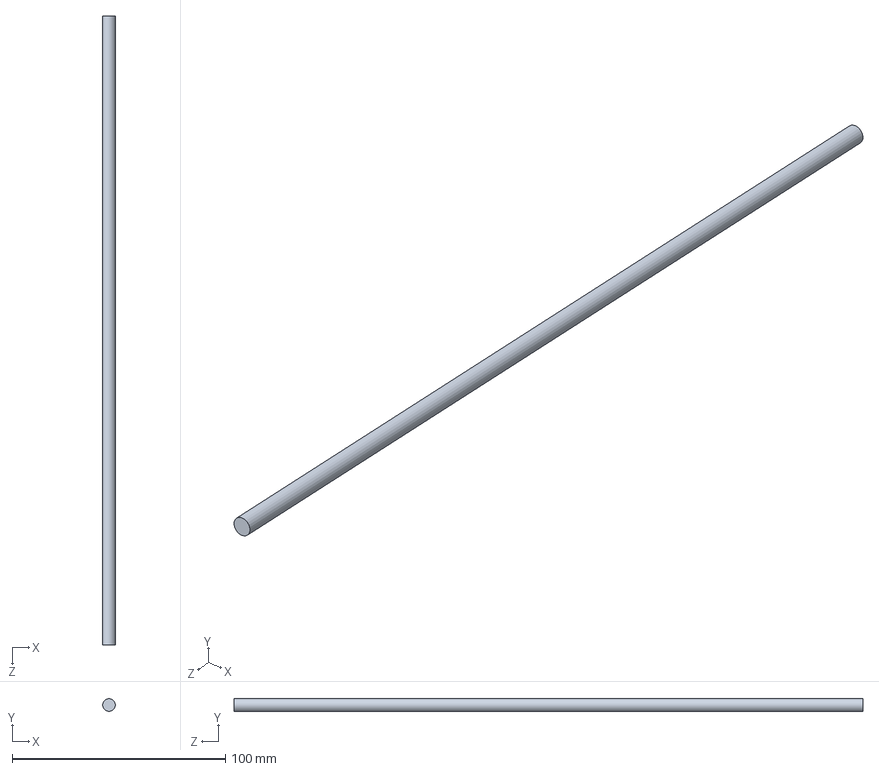
[picture p27: CAD file, 2025-08-06]
CAD file Pen plotter/Y_AXIS_PARTS/y_axis_parallel_shaft.SLDPRT
6.00 x 6.00 x 295.0 mm
