tirthlodaya/Pen-Plotter/CAD file Pen plotter/Z_AXIS_PARTS/pen.SLDPRT

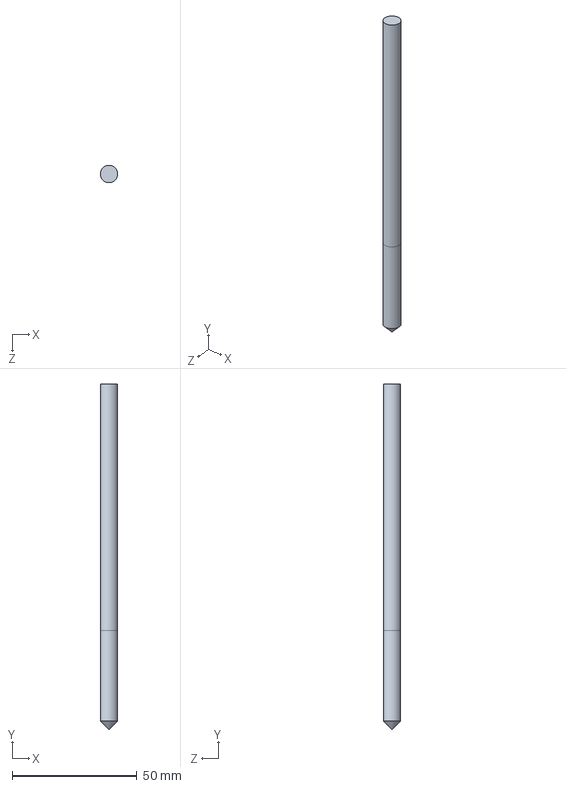
[picture p28: CAD file, 2025-08-06]
CAD file Pen plotter/Z_AXIS_PARTS/pen.SLDPRT
7.00 x 138.5 x 6.96 mm
