tirthlodaya/Pen-Plotter/CAD file Pen plotter/dc-motor-gearbox-tt-motor-1.snap 2/Gearbox.SLDPRT

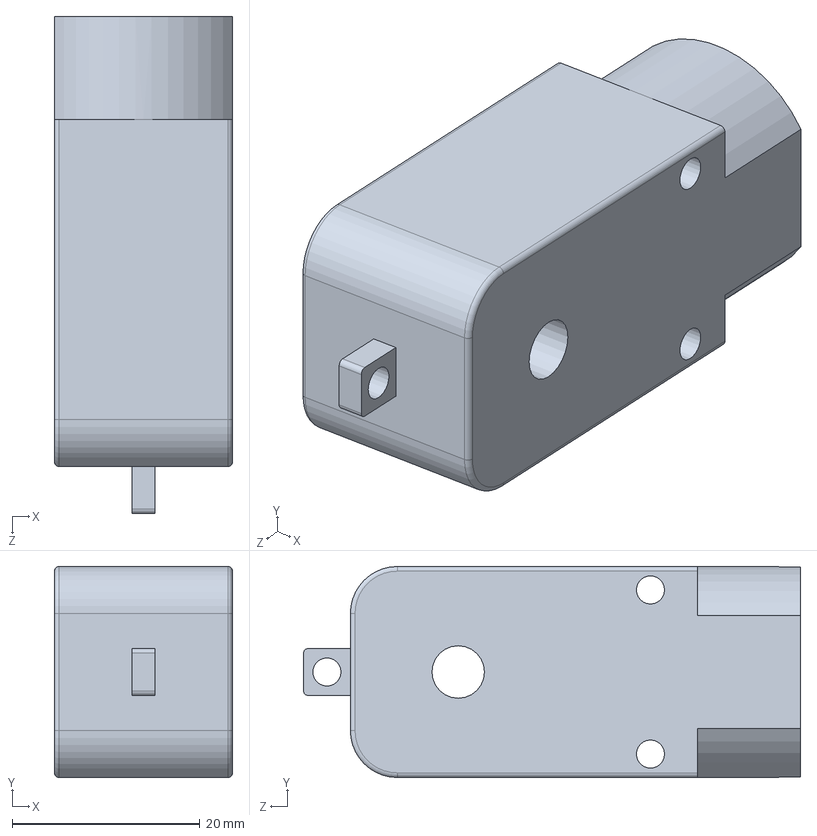
[picture p29: CAD file, 2025-08-06]
CAD file Pen plotter/dc-motor-gearbox-tt-motor-1.snap 2/Gearbox.SLDPRT
19.0 x 22.5 x 53.0 mm
