tirthlodaya/Pen-Plotter/CAD file Pen plotter/extra/fixed position.SLDPRT

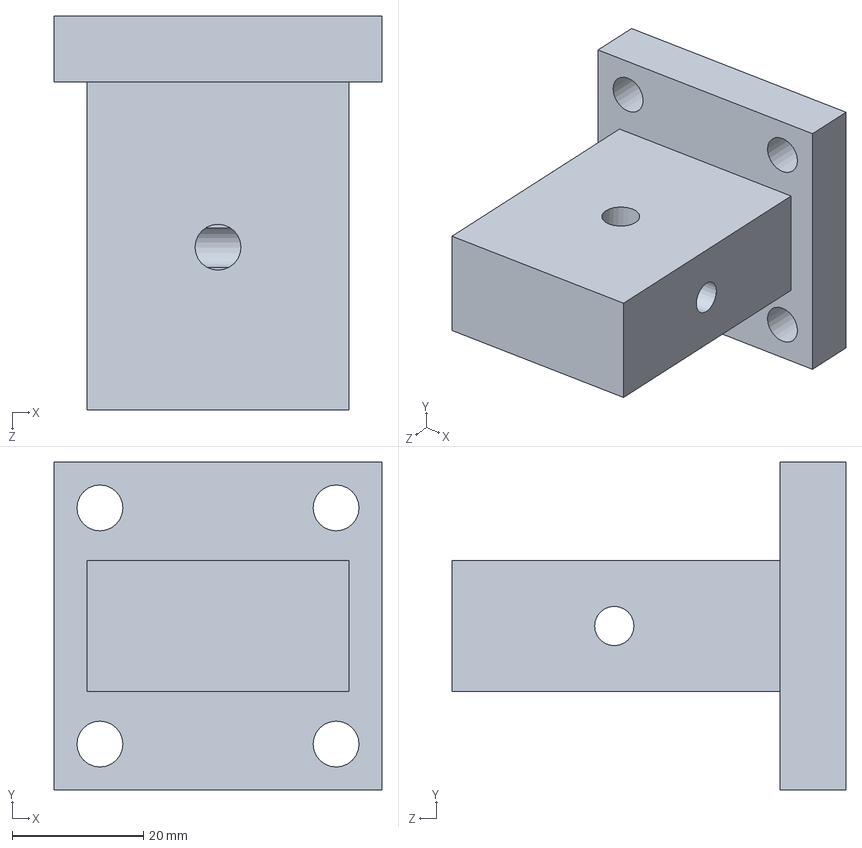
[picture p30: CAD file, 2025-08-06]
CAD file Pen plotter/extra/fixed position.SLDPRT
50.0 x 50.0 x 60.0 mm
