tirthlodaya/Pen-Plotter/CAD file Pen plotter/GENERAL_PARTS/base Of Pen Plotter.SLDPRT

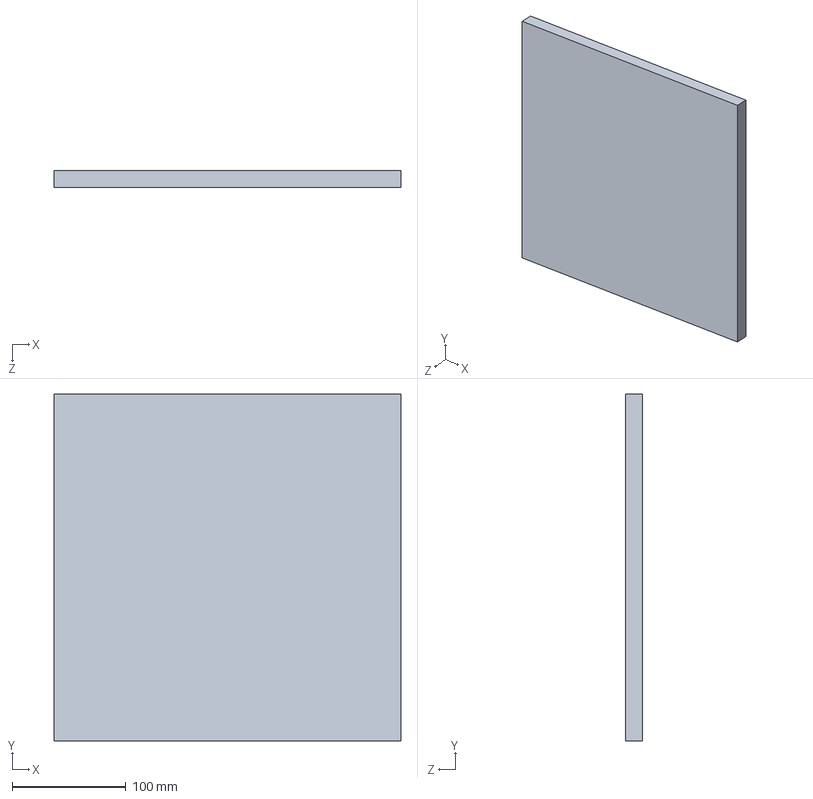
[picture p31: CAD file, 2025-08-06]
CAD file Pen plotter/GENERAL_PARTS/base Of Pen Plotter.SLDPRT
305.0 x 305.0 x 15.0 mm
