tirthlodaya/Pen-Plotter/CAD file Pen plotter/SERVO/SG90_Arm_01_Custom.step.SLDPRT

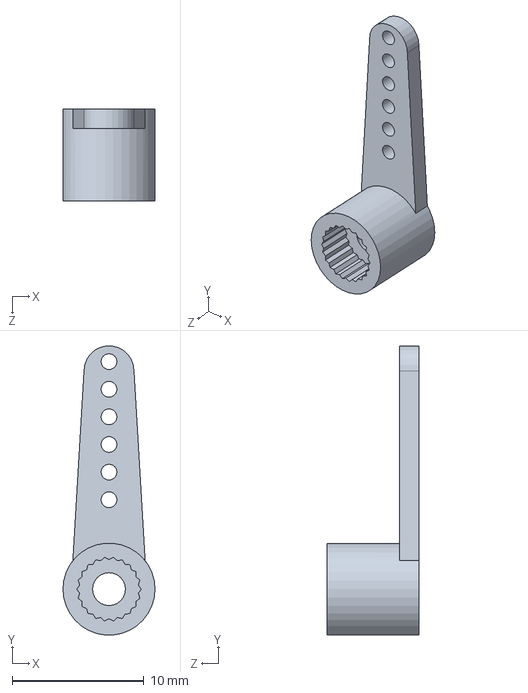
[picture p32: CAD file, 2025-08-06]
CAD file Pen plotter/SERVO/SG90_Arm_01_Custom.step.SLDPRT
7.00 x 22.0 x 7.00 mm
