tirthlodaya/Pen-Plotter/CAD file Pen plotter/X_AXIS_PARTS/x axis belt.SLDPRT

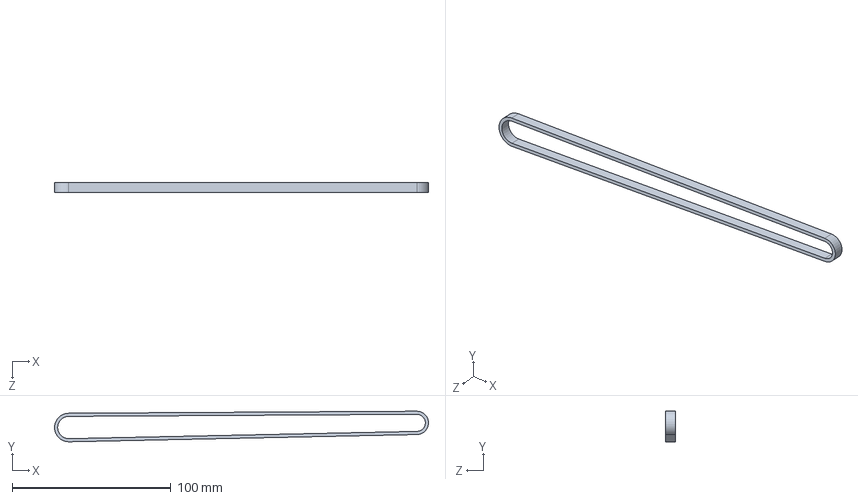
[picture p33: CAD file, 2025-08-06]
CAD file Pen plotter/X_AXIS_PARTS/x axis belt.SLDPRT
235.3 x 19.3 x 6.00 mm
