tirthlodaya/Pen-Plotter/CAD file Pen plotter/Y_AXIS_PARTS/y axis rod support_w_motor.SLDPRT

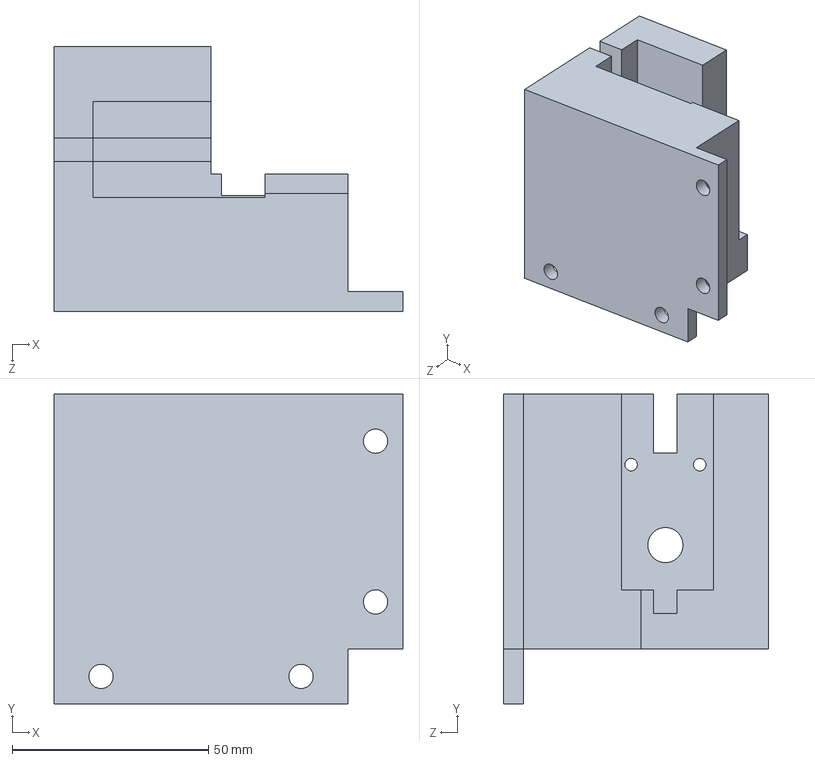
[picture p34: CAD file, 2025-08-06]
CAD file Pen plotter/Y_AXIS_PARTS/y axis rod support_w_motor.SLDPRT
89.0 x 79.0 x 67.5 mm
