tirthlodaya/Pen-Plotter/CAD file Pen plotter/Z_AXIS_PARTS/z_axis movable part.SLDPRT

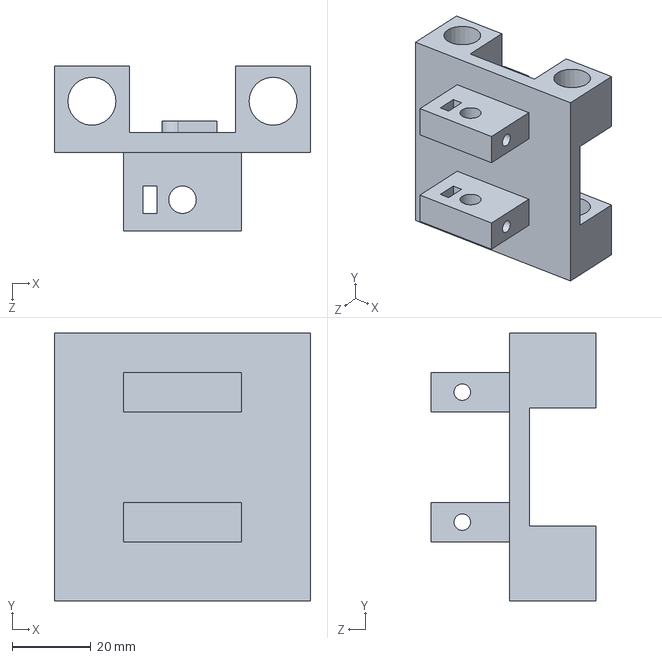
[picture p35: CAD file, 2025-08-06]
CAD file Pen plotter/Z_AXIS_PARTS/z_axis movable part.SLDPRT
65.0 x 68.0 x 42.0 mm
