tirthlodaya/Pen-Plotter/CAD file Pen plotter/dc-motor-gearbox-tt-motor-1.snap 2/output shaft.SLDPRT

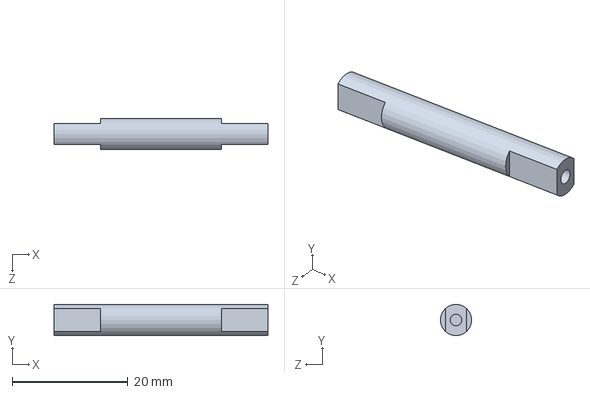
[picture p36: CAD file, 2025-08-06]
CAD file Pen plotter/dc-motor-gearbox-tt-motor-1.snap 2/output shaft.SLDPRT
37.0 x 5.40 x 5.40 mm
