tirthlodaya/Pen-Plotter/CAD file Pen plotter/SERVO/rotating_part on servo.SLDPRT

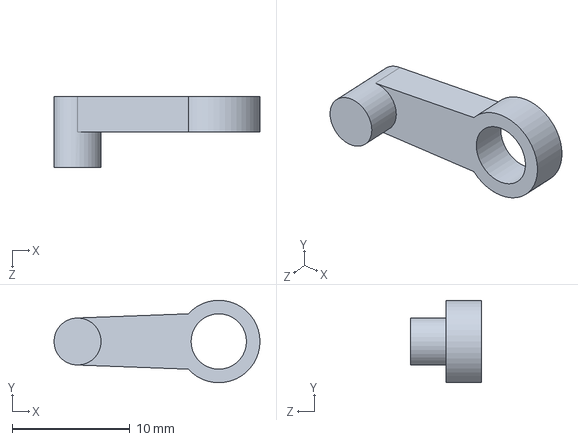
[picture p37: CAD file, 2025-08-06]
CAD file Pen plotter/SERVO/rotating_part on servo.SLDPRT
17.5 x 7.00 x 6.00 mm
