tirthlodaya/Pen-Plotter/CAD file Pen plotter/X_AXIS_PARTS/x axis rod support_w_motor.SLDPRT

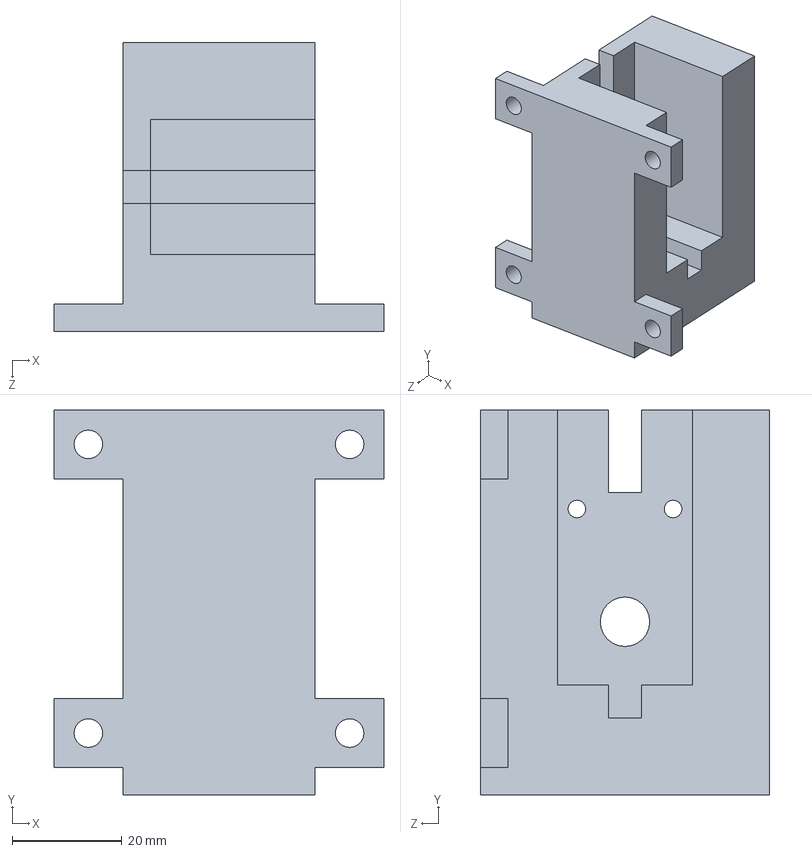
[picture p38: CAD file, 2025-08-06]
CAD file Pen plotter/X_AXIS_PARTS/x axis rod support_w_motor.SLDPRT
60.0 x 70.0 x 52.5 mm
