tirthlodaya/Pen-Plotter/CAD file Pen plotter/Y_AXIS_PARTS/y_axis_trolley.SLDPRT

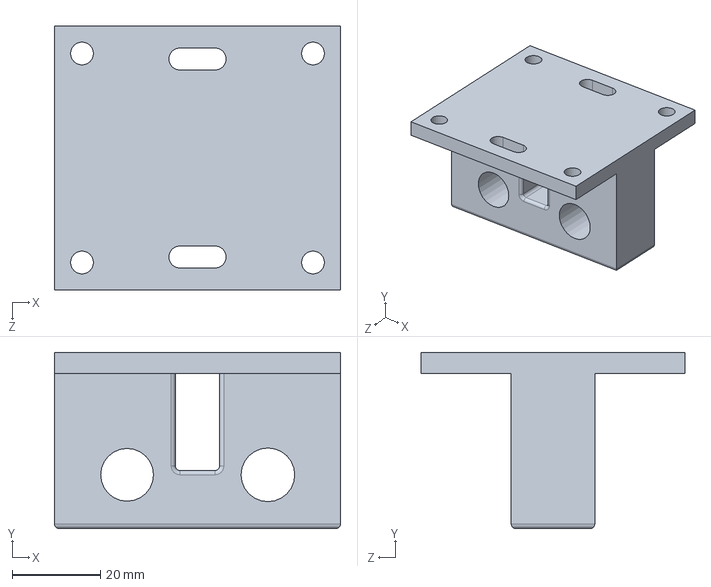
[picture p39: CAD file, 2025-08-06]
CAD file Pen plotter/Y_AXIS_PARTS/y_axis_trolley.SLDPRT
65.0 x 40.0 x 60.0 mm
