tirthlodaya/Pen-Plotter/CAD file Pen plotter/Z_AXIS_PARTS/z_axis shaft.SLDPRT

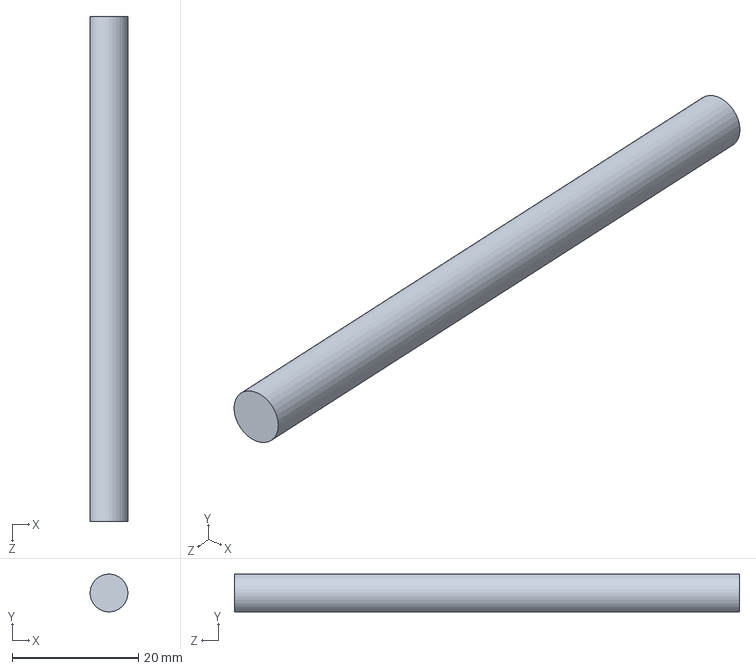
[picture p40: CAD file, 2025-08-06]
CAD file Pen plotter/Z_AXIS_PARTS/z_axis shaft.SLDPRT
6.00 x 6.00 x 80.0 mm
