tirthlodaya/Pen-Plotter/CAD file Pen plotter/dc-motor-gearbox-tt-motor-1.snap 2/motor.SLDPRT

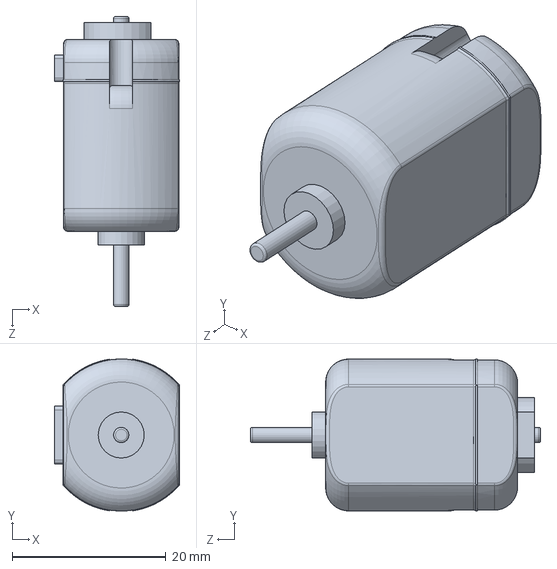
[picture p41: CAD file, 2025-08-06]
CAD file Pen plotter/dc-motor-gearbox-tt-motor-1.snap 2/motor.SLDPRT
16.3 x 19.8 x 37.8 mm
