tirthlodaya/Pen-Plotter/CAD file Pen plotter/X_AXIS_PARTS/x_axis shaft.SLDPRT

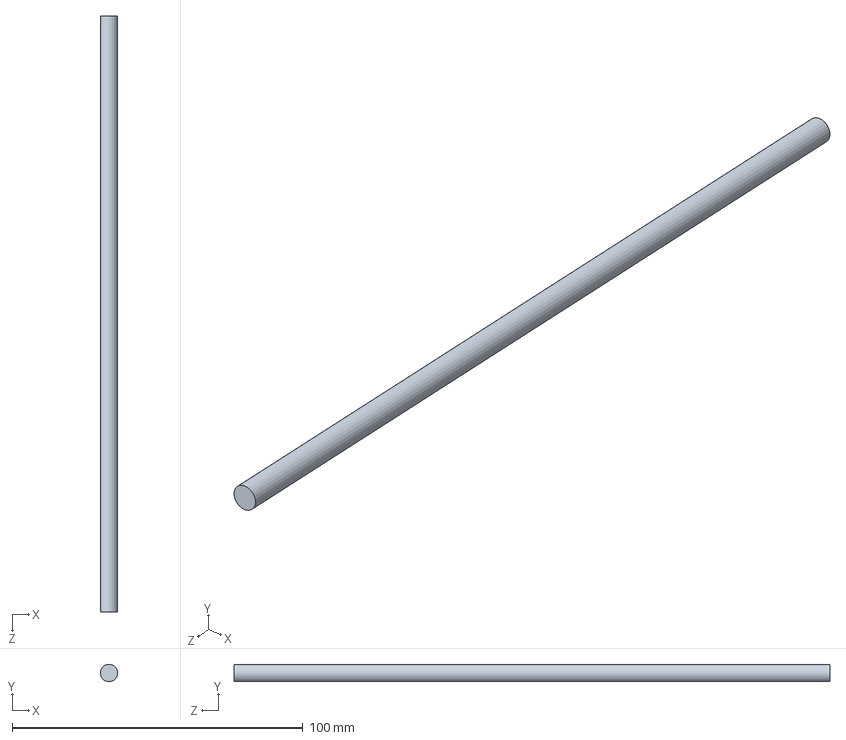
[picture p42: CAD file, 2025-08-06]
CAD file Pen plotter/X_AXIS_PARTS/x_axis shaft.SLDPRT
6.00 x 5.96 x 205.0 mm
