tirthlodaya/Pen-Plotter/CAD file Pen plotter/Y_AXIS_PARTS/y_axis_shaft.SLDPRT

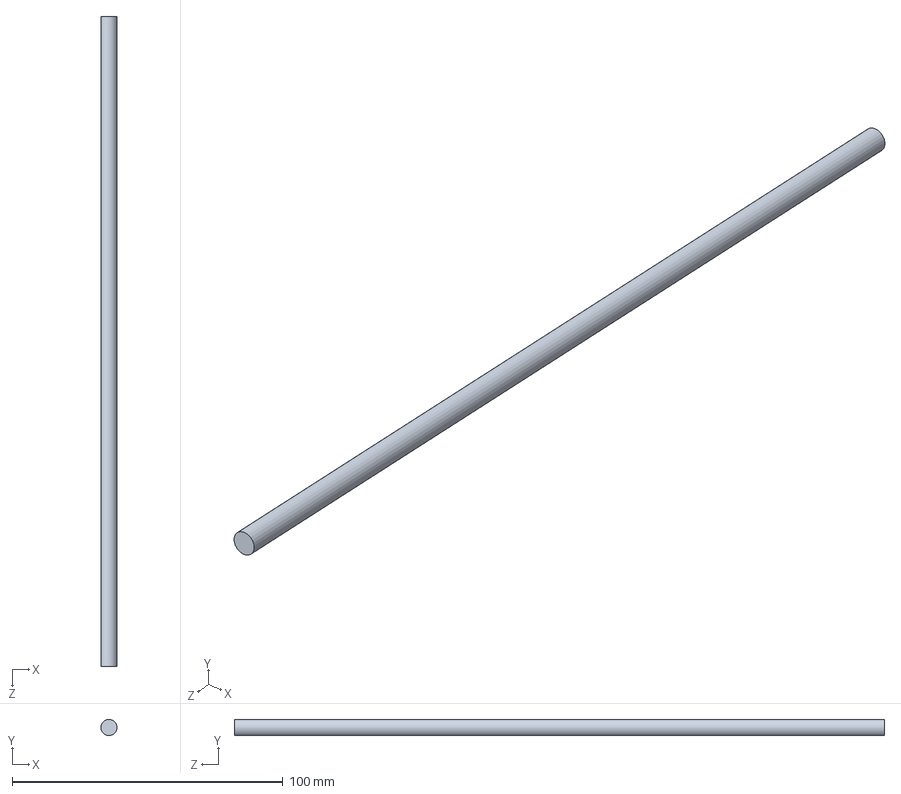
[picture p43: CAD file, 2025-08-06]
CAD file Pen plotter/Y_AXIS_PARTS/y_axis_shaft.SLDPRT
6.00 x 5.99 x 240.0 mm
