tirthlodaya/Pen-Plotter/CAD file Pen plotter/X_AXIS_PARTS/x_axis_end_support_guide.SLDPRT

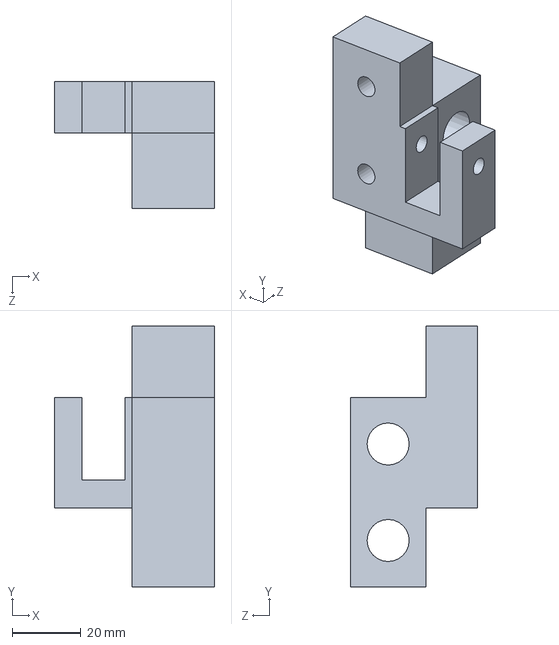
[picture p44: CAD file, 2025-08-06]
CAD file Pen plotter/X_AXIS_PARTS/x_axis_end_support_guide.SLDPRT
46.5 x 75.8 x 37.0 mm
