tirthlodaya/Pen-Plotter/CAD file Pen plotter/Y_AXIS_PARTS/y axis belt.SLDPRT

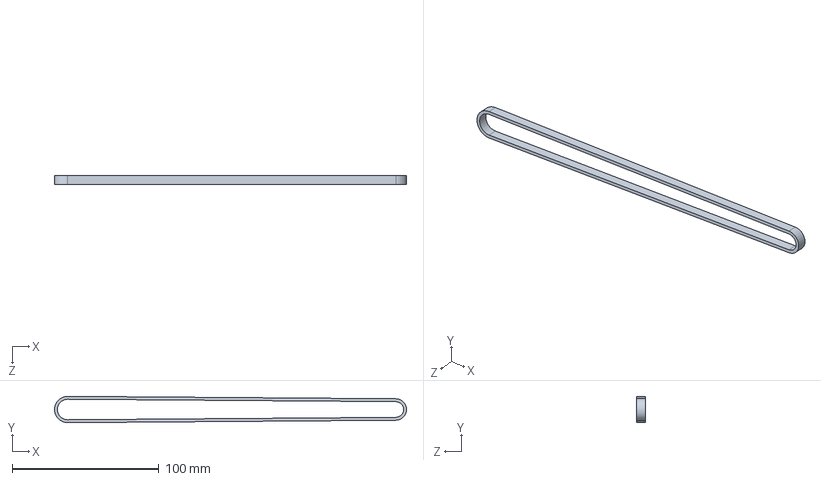
[picture p45: CAD file, 2025-08-06]
CAD file Pen plotter/Y_AXIS_PARTS/y axis belt.SLDPRT
240.3 x 18.0 x 6.00 mm
