tirthlodaya/Pen-Plotter/CAD file Pen plotter/Y_AXIS_PARTS/y_axis_right support.SLDPRT

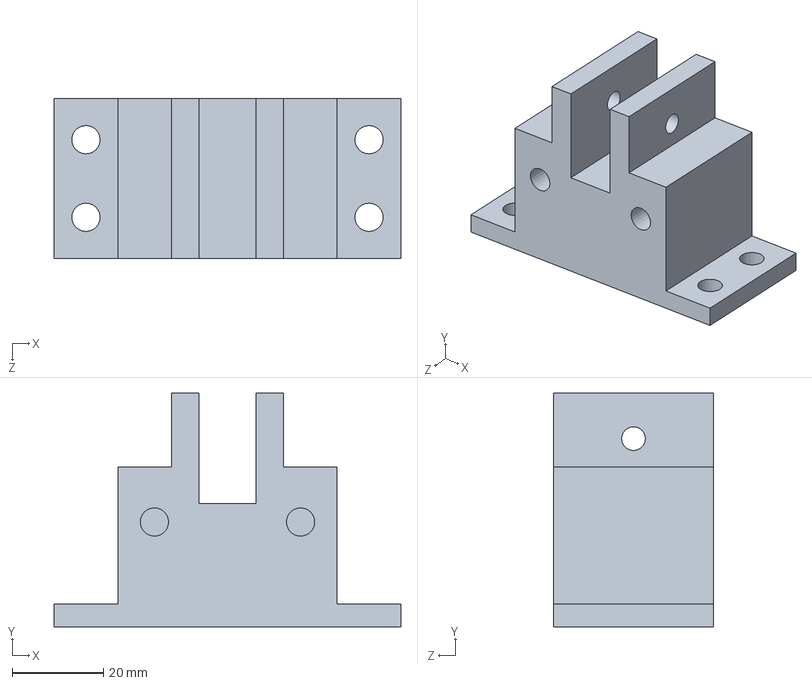
[picture p46: CAD file, 2025-08-06]
CAD file Pen plotter/Y_AXIS_PARTS/y_axis_right support.SLDPRT
76.0 x 51.2 x 35.0 mm
