tirthlodaya/Pen-Plotter/CAD file Pen plotter/Y_AXIS_PARTS/y_axis_parallel_support.SLDPRT

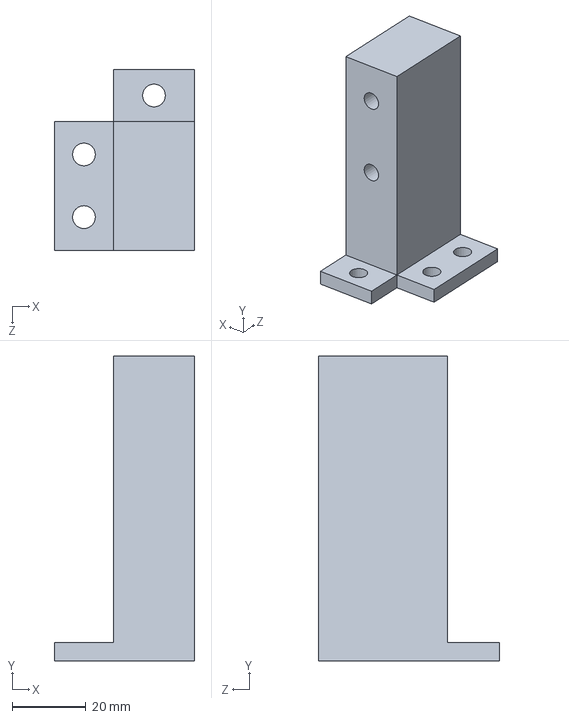
[picture p48: CAD file, 2025-08-06]
CAD file Pen plotter/Y_AXIS_PARTS/y_axis_parallel_support.SLDPRT
38.0 x 82.8 x 49.0 mm
