tirthlodaya/Pen-Plotter/(list of files, cad)

Other CAD files:
CAD file Pen plotter/FULL_ASSEMBLY/Full_Assembly_Deliverable_1_Team16_woc.STEP
CAD file Pen plotter/pen_plotter_layout.SLDPRT
CAD file Pen plotter/SERVO/SG90_Arm_01_Custom.SLDPRT
CAD file Pen plotter/FULL_ASSEMBLY/Full_Assembly_Deliverable_1_Team16.SLDASM
CAD file Pen plotter/dc-motor-gearbox-tt-motor-1.snap 2/DC Motor Gearbox.SLDASM
