tirthlodaya/Pen-Plotter/(list of files, drawings)

Other design files:
electronics_penplotter/Circuit_diagram.fzz
electronics_penplotter/Schematic.fzz
